hjkim602hjk-lgtm/ROS2_CWU/docs/superpowers/specs/2026-10-30-mission2-design.md

---
title: 미션2 설계 — 빠른 확보 · (3,3)~(7,7) 순환 · 보유 상대 모서리 밀기
tags:
  - cwu/design
  - cwu/nav
---

# 미션2 설계 — 빠른 확보 · 순환 유지 · 보유 상대 밀어내기

**작성일:** 2026-10-30 (사용자와 대화로 확정, Claude 작성)
**대체:** [[docs/superpowers/specs/2026-09-16-mission2-control-design|9-16 codex 초안]]은 회피 위주였고 이 문서가 대신합니다.
**순서:** Gazebo 시뮬레이션에서 먼저 완성 → 그 다음 실물 시험.

## 1. 의도

승리 조건은 "5분 끝났을 때 목표물을 쥐고 있는 로봇"(규정 24조)입니다. 사용자 판단:

1. **빨리 인식하고 빨리 잡는 것이 승패를 가른다.** 출발 직후 중앙으로 곧장 달려간다.
2. 쥔 뒤에는 (5,5) 주위 **(3,3)~(7,7) 테두리 칸(반지름 약 800 mm)을 계속 돈다.** 가만히 서 있지 않는다.
   밀려나면 빠져나와 다시 그 고리로 돌아온다.
3. 상대가 먼저 쥐었으면 **빼앗지 않고, 그 상대를 모서리 탈락 칸으로 밀어 넣는다.** 탈락하면 목표물이
   중앙으로 재배치되므로(23조) 다시 잡으러 간다.
4. 확보 판정: 집게가 닫힘이고 정면 PSD가 임계 이상이면 쥐고 있음. 제대로 잡았다면 움직이고 돌아도 유지된다.

## 2. 목표 / 비목표 / 실패

- **목표:** 시뮬레이션에서 네 대가 같은 거리에서 출발할 때, 5분 종료 시점 보유율을 최대화.
- **비목표:** 상대 그리퍼에서 직접 빼앗기, 상대 정체 식별(팀 구분), SLAM, Nav2.
- **실패로 보는 것(돌아가도):** 우리 로봇이 모서리 칸에 들어감. 상대 몸체를 목표물로 보고 집게를 닫음.
  밀기 중 과격한 반복 들이받기(규정 21조 파손 금지). 경기장 공개 후 값 수정이 필요한 구조(규칙 5).

## 3. 제약

- CLAUDE.md 필수 제약 1~10 그대로. 전부 Pi 4에서, 시작 명령 뒤에는 외부 통신 없음.
- 하드웨어는 미션1과 동일(7번). 펌웨어 속도 모드: `/cmd_vel` → `encoder_odom` → 보드, 집게·무장은 `/base/command`
  ("ARM", "7" 열기, "8" 잡기), 텔레메트리 `/base/telemetry`(PSD raw ADC, 필드 번호는 `mission_logic.py`).
  펌웨어 한계 0.15 m/s, 1.2 rad/s(`fake_board.py`).
- 카메라는 색만 씀. 출력은 `/target/bearing`(방향만, 거리 없음). 거리는 정면 PSD만(CLAUDE.md 카메라 역할).
- 정면 PSD만 파지를 트리거. 튜닝값은 전부 `mission2.yaml`에 넣고 경기장 공개 전에 확정.

## 4. 정해진 설계

### 4.1 경기장 좌표계 (LiDAR 벽)

- 경기장은 내부 장애물이 없는 3600 × 3600 mm 정사각형. LiDAR(높이 170 mm)는 외벽과 로봇만 봄.
  목표물(50 mm)은 LiDAR 아래라 안 보임.
- 좌표계: 원점 = 경기장 중앙, 축 = 벽 방향. 칸 (i,j) 중심 = ((i-5)·0.4, (j-5)·0.4) m.
- 네 출발 칸 (2,2)/(2,8)/(8,2)/(8,8)은 중앙 기준 90° 대칭이고, 이 미션에서 의미 있는 곳(중앙, 고리, 네 모서리)도
  모두 대칭이라 **어느 출발 칸인지 알 필요가 없음**. 출발 시 로봇이 있는 사분면을 (2,2)로 정의함. 시작 위치 인자 없음.
- 추정: 엔코더 odom을 예측으로 쓰고, 스캔에서 벽 직선을 찾아 보정함. 벽만 인정하고 상대 로봇은 버림
  (예: 경기장 크기에 맞는 긴 직선만 쓰고, 예측 벽 위치에서 먼 짧은 점 묶음은 무시). 구체 알고리즘은 빌더 몫이지만
  **두 개 이상의 벽이 가려지는 경우에도 위치가 튀지 않아야 함**. 기존 `grid.py`의 `lattice_fix`·`wall_heading`을 먼저 검토할 것.
- **보정 때문에 멈추지 않음(Claude 결정):** 미션1은 늦게 오는 스캔 때문에 멈춘 뒤에만 보정했지만, 미션2는 계속 움직여야
  하므로 스캔 시각(stamp)의 odom 자세(TF 이력)에 스캔을 붙여 주행 중에도 보정. Pi에서 스캔마다 돌 수 있게 계산량을 잴 것
  (`lattice_fix`는 한 번에 약 54 ms).

### 4.2 상태와 동작

| 상태 | 들어오는 조건 | 하는 일 |
|---|---|---|
| `SPIN` | 출발 | **바로 제자리 반시계(왼쪽) 회전**(사용자 결정). 목표물 위치가 정해져 있고 출발 자세에서 중앙이 왼쪽에 있으므로 돌면서 카메라로 빨간색을 찾음 → 보이면 즉시 `APPROACH`. 정해진 각도(YAML, 중앙 방향 + 여유)를 다 돌아도 안 보이면 `RUSH` |
| `RUSH` | `SPIN`에서 못 찾음, 놓침, 상대 탈락 | 중앙 방향으로 최고속 직진. 카메라에 빨간색이 잡히면 `APPROACH` |
| `APPROACH` | 바닥의 목표물이 보임 | 미션1처럼 빨간색을 화면 세로 중앙선에 맞추며 전진, 정면 PSD 임계 지속 → 정지 → "8" 닫기 → `HOLD` |
| `HOLD` | 확보 판정 참 | 고리 순환(4.3). 놓침 판정 → "7" 열기 → `RUSH`(목표물 재탐색) |
| `PUSH` | 상대가 쥐었다고 판정(4.4) | 보유 상대를 가장 가까운 모서리 칸으로 밀기(4.5). 대상 소실/탈락 → `RUSH` |
| `FINISH` | 경기 시간 300 s 경과(온보드 단조 시계) | 정지, 집게는 닫힌 채 유지 |

- **목표물이 안 보일 때(`RUSH`):** 중앙을 바라보며 중앙으로 감. 중앙 근처까지 와도 안 보이면 제자리에서 돌며 찾음.
  23조에 따라 재배치는 "중앙 주변"일 수 있으므로 정확히 (5,5)라고 가정하지 않음.
- **모서리 금지(모든 상태 최우선):** 네 모서리 칸(1,1)(1,9)(9,1)(9,9) + 로봇 반지름 + 여유(YAML)는 진입 금지.
  금지 영역 쪽으로 향하는 속도 성분은 잘라냄. 위치 신뢰도가 낮으면 모서리 쪽 이동 정지.
- **파지 활성화는 `APPROACH`에서만.** `PUSH` 중에는 정면 PSD가 상대 몸체에 반응해도 닫지 않음.

### 4.3 순환 (HOLD)

- 경로: (3,3)~(7,7) 테두리 칸 중심을 지나는 고리. 반지름 약 800 mm(정사각형 테두리 또는 원 — 빌더 몫, 단 칸 (3,3)~(7,7)
  테두리 안에 머물러야 함). 방향은 한쪽으로 고정.
- 쥔 위치에서 고리의 가장 가까운 점으로 합류. 밀려서 고리를 벗어나면 다시 가장 가까운 점으로 합류.
- **상대가 다가오면 피함(사용자 결정).** 상대 반대쪽으로 비킨 뒤 고리로 다시 합류. 비키는 방향에도 모서리 금지(4.2)가
  우선하므로 모서리 쪽으로는 비키지 않음. 다가옴 판정 거리·비키는 거리는 YAML.
- 순환 중에도 확보 판정을 계속 확인.

### 4.4 확보·놓침·상대 보유 판정

- **우리 확보:** 집게 닫힘 완료 AND 정면 PSD ≥ 임계(기존 `psd_threshold` 550)가 연속 N 표본.
- **놓침:** 집게 닫힘인데 정면 PSD < 임계가 보정된 시간 이상 지속. 순간 튀는 값으로 놓지 않음.
- **상대 보유:** 빨간색 방향선 위에 LiDAR 물체(=로봇)가 있고, 그 물체가 중앙에서 일정 거리(YAML) 이상 떨어져 있음.
  목표물은 LiDAR에 안 보이므로 "빨간 방향에 LiDAR 물체가 걸린다 = 누가 들고 있다"로 봄. 바닥에 놓인 목표물을
  상대가 그냥 가리고 있는 경우와의 구분은 시뮬레이션에서 다듬음.
- **동시 확보 금지(사용자 결정):** 상대 그리퍼의 목표물을 같이 쥐지 않음(25조 재경기 회피). `APPROACH`에서 파지 직전
  정면에 LiDAR 물체(로봇)가 붙어 있으면 닫지 않고 `PUSH`로 전환. 상대가 중앙 가까이 있어 위 "중앙에서 일정 거리" 조건이
  안 맞아도 마찬가지.
- **LiDAR에 상대가 안 보이면(Claude 결정):** 대비책 없음. 상대가 안 보이면 `PUSH`를 하지 않고 `RUSH`/`HOLD`만 함.
  좌·우·뒤 PSD는 용도 미정이라 쓰지 않음.

### 4.5 밀기 (PUSH)

- 대상 상대 위치(LiDAR 물체)에서 가장 가까운 모서리 칸을 고름.
- 상대의 "모서리 반대편" 지점으로 돌아 들어간 뒤, 상대 → 모서리 방향으로 직진해 밀기.
- 우리 로봇은 모서리 금지 경계 앞에서 멈춤(4.2 금지 규칙이 이것을 강제). 상대만 들어가면 됨.
- 한 번 밀다가 실패(상대가 빠져나감)하면 다시 반대편으로 돌아 들어감. 들이받기 속도는 YAML 상한.

## 5. 시뮬레이션

기존 `cwu_sim`(Gazebo Classic, `fake_board`, `track_recorder`, 웹캠·PSD·LiDAR 모델)을 재사용함.

- **경기장:** 장애물 없는 3.6 m 외벽, 빨간 50 mm 큐브 (5,5). 우리 로봇은 네 출발 칸 중 하나에서 출발(시드로 선택,
  출발 방향은 "중앙이 로봇 왼쪽"(미션1 시뮬레이션과 같은 관례) ± 시드별 작은 오차).
- **상대 3대:** 나머지 출발 칸에서 출발하는 단순 로봇(LiDAR 높이에 걸리는 크기). 스크립트가 움직임:
  중앙으로 돌진 → 먼저 닿은 로봇이 쥠 → 쥔 상대는 돌아다니고, 안 쥔 상대는 보유자를 쫓아감. 속도는 시드로 섞어
  "우리가 먼저 잡는 판"과 "상대가 먼저 잡는 판"이 둘 다 나오게 함.
- **심판 스크립트:** 쥔 로봇을 따라 큐브를 옮김(우리 포함 — 지금 `fake_board`는 쥐면 큐브를 지우는데, 미션2에서는
  지우지 않고 따라붙게 바꿔야 23조 재배치가 가능), 로봇 중심이 모서리 칸에 들어가면 탈락 처리, 보유자가 탈락하면
  큐브를 (5,5)(로봇이 있으면 근처)로 재배치, 300 s에 결과 판정.
- **실행:** `tools/sim/run_maze.sh`와 같은 형태의 한 판 스크립트, 결과 한 줄(시드, 300 s 시점 보유자, 우리 탈락 여부,
  우리 누적/마지막 연속 보유 시간, 처음 잡은 시각).
- **반복 기준:** 여러 시드를 돌려 실패 판을 고침. 우리 로봇의 모서리 진입은 0회여야 함.

## 6. 빌더에게 맡김

- 노드·모듈 구성. 단, 미션1처럼 ROS 없는 판단 함수(좌표계 보정, 고리 목표점, 모서리 금지, 밀기 지점, 판정)를
  pytest로 검증 가능하게 분리.
- 벽 정합 알고리즘, 상대 물체 묶음 방식, 고리 모양(원/사각), 상대 로봇 Gazebo 구동 방식.
- 모든 수치(속도, 여유, N 표본, 시간)는 `mission2.yaml`. 실물 값이 미션1 것과 같은 항목은 미션1 값을 시작점으로.

## 7. 실물로 넘어갈 때 확인할 것

- 상대 로봇이 벽을 가릴 때 위치 추정이 버티는지, 밀릴 때 엔코더가 미끄러져도 벽 보정으로 돌아오는지.
- 쥔 상태로 돌고 밀릴 때 정면 PSD가 임계 이상으로 유지되는지(사용자 주장 확인).
- 실제 상대 로봇 크기·높이가 LiDAR에 걸리는지.

## 관련 문서

- [[docs/competition_rules|대회 규정]] 15~27조
- [[docs/superpowers/specs/2026-09-16-mission1-control-design|미션1 제어 설계]]
- [[docs/superpowers/specs/2026-09-16-psd-gripper-design|PSD 자동 파지 설계]]
