hjkim602hjk-lgtm/ROS2_CWU/docs/2026-09-29-실물-주행-시험-기록.md

---
title: 2026-09-29 실물 주행 시험 기록
tags:
  - cwu/hardware
  - cwu/log
---

# 2026-09-29 실물 주행 시험 기록

Nucleo-F446RE 모터·엔코더와 `encoder_odom`을 실물 로봇으로 처음 맞춰 본 날의 기록입니다.
결론부터: **엔코더 오도메트리는 직진에서 맞지만, 모터 출발 순간의 전기 잡음으로 Nucleo의 USB 시리얼(ST-Link)이 깨지거나 멈춥니다.** 제자리 회전 오도메트리는 아직 검증되지 않았습니다.

## 구성

- 전원: 배터리에서 선을 따로 빼 USB-C로 Pi에 공급. 모터 전원은 같은 배터리에서 MDD10A로 들어가며, 로봇에서 따로 끌 수 없음.
- Pi ↔ Nucleo: USB(`/dev/ttyACM0`, ST-Link V2.1 `0483:374b`), 115200 baud.
- 펌웨어: 팀 원본(커밋 `44f761e`, `changwon_robot_2026-09-29.zip`)에 안전 수정을 더한 판. 현재 파일은
  `firmware/nucleo/legacy/changwon_robot_stm_20260929.ino.txt`. 한 글자 명령 `f b l r s z 1 2`, 출력 `ENC,<left>,<right>` 100 ms마다, 고정 PWM 100.

## 실측 값 (`src/cwu_base/config/encoder.yaml`에 반영)

| 항목 | 값 | 근거 |
|---|---|---|
| 바퀴 반지름 | 0.04265 m | 지름 85.30 mm 실측 |
| 트레드 | 0.20686 m | 206.86 mm 실측 |
| 회전당 틱 | 3009.5 | 손으로 1회전: L 3004, R 3015의 평균 |
| 필드 / 부호 | L=0, R=1, 부호 +1 | 전진 시 둘 다 증가 확인 |
| PWM 100 바퀴 속도 | 약 0.14 m/s (100 ms당 약 155틱) | 바퀴 띄운 시험 |

## 시험 결과

| 시험 | 결과 |
|---|---|
| 직진 1 m | `/odom` 1.039 m 전진, 오른쪽 12.5 cm / 실측 약 1 m, 약 12 cm. **옆 방향 일치.** 앞 방향 약 4 cm 차이는 정밀 재측정 필요(맞으면 반지름 약 0.04105 m로 보정). 오른쪽으로 휘는 것은 좌우 모터 속도 차이 → 속도 제어로 해결할 문제. |
| 제자리 회전(1차, 명령 만료 전 펌웨어) | 실제 반시계 약 1050°, `/odom`은 −15.5°. 회전 중 엔코더 데이터가 세 번 끊김. **실패, 원인 미확정.** |
| 재시도 | ST-Link 시리얼이 완전히 멈춤. USB를 뽑았다 꽂아야 복구. |
| 명령 만료 정지 | `f` 한 번 → 0.299초 뒤 `CMD: TIMEOUT STOP`. **동작.** |
| 바퀴 띄운 f/l/b/r 각 2초 | 달리는 동안은 줄 누락·역행 틱 없음. **출발 순간에만** 바이트가 깨짐(`CMD: RIGH552`, `ENC,CMD: LE7`)·0.5초 끊김 1회. 끊긴 동안 Pi → Nucleo 명령도 막혀 명령 만료 정지가 한 번 작동. |
| 바닥 한 바퀴(목표 틱 7298) | 출발 직후 Nucleo → Pi 수신만 멈춤. 명령은 계속 전달돼 로봇이 약 570° 돌고 스크립트의 8초 제한에서 정지. USB 재연결로 복구. |
| 바퀴 띄운 f/l/b/r 각 2초 (소프트 스타트판) | 네 방향 모두 공백·깨진 줄·역행 틱 없음. 출발 틱 54 → 123 → 147로 소프트 스타트 확인. **출발 잡음 해결.** |
| 바닥 한 바퀴 (소프트 스타트판) | 7336틱에서 스스로 정지, 계산 약 364°, 실제도 제자리 복귀(눈으로 확인). 시리얼 멈춤 없음, 주행 중 0.2 s 공백 1회. **통과.** |
| 바닥 직진 1 m (소프트 스타트판, 카메라 연결) | 주행 중 0.2 s 공백 3회·깨진 줄 후 2.87 s(약 0.3 m)에 안전 정지, 이후 ST-Link 수신 멈춤. 커널 로그: 14:45부터 11분간 USB over-current 5609줄, RealSense 재연결 153회, 저전압 기록(`throttled=0x50000`). 재꽂은 뒤 `/dev/ttyACM0`가 root 0600으로 생겨 재부팅. |
| 바닥 직진 0.8 m (재부팅, **카메라 뺌**) | `throttled=0x0`, over-current 0, USB 재연결 없음, 시리얼도 멈추지 않음. 그래도 주행 중 0.2~0.39 s 공백 7회·깨진 줄(`ENC,352`, 오른쪽 증분 4106 등)로 4.78 s에 안전 정지. 엔코더 최종값 L 6202 / R 6072틱(정지 후 관성 포함) → **약 0.55 m**. 스크립트의 누적 4796틱(0.43 m)은 한 줄에 400틱 넘게 뛴 구간을 빼고 세서 적게 나온 값. 줄자 실측은 안 함. **USB 전원 문제와 별개로 주행 중 데이터 깨짐이 남음 → 배선 보강(A) 필요.** |
| 바닥 직진 1 m (2026-09-30, 카메라 뺌, 끊김 기준 1 s) | 목표 11231틱. 주행 중 0.2~0.29 s 공백 4회는 무시하고 진행. 8.02 s에 ST-Link가 **양방향** 약 5초 멈춤 → 스크립트 write가 막혀 루프 정지, 펌웨어 명령 만료로 모터 정지. 복구 후 엔코더 L 11309 / R 11308틱 → **약 1.007 m**. **실측 0.98 m, 옆 틀어짐 육안으로 안 보임** → 엔코더가 2.75% 길게 셈. 유효 반지름 0.04265 → **0.04151 m**로 보정(`encoder.yaml`, `motor.yaml`). 이후 스크립트에 `write_timeout` 추가. |
| 바닥 한 바퀴 재시험 ×2 (2026-09-30, 새 반지름, 목표 7499틱) | 두 번 모두 **출발 0.1~0.2초 만에 Nucleo → Pi 수신이 멈춤**. 1 s 끊김 기준으로 정지. 1차 뒤 엔코더가 L −1376 / R +1324 늘어 있어, 수신이 끊긴 채 약 1초(약 60°) 더 돈 것으로 봄(송신은 살아 있던 한 방향 멈춤). 2차 뒤에는 포트 열기·읽기까지 막힘 → USB 재연결 필요. `throttled=0x0`, USB 커널 이벤트 없음. 어제 같은 시험은 통과했으나 오늘은 2/2 실패. |

## 끊김 현상 정리 (2026-09-30 기준)

Nucleo ↔ Pi 시리얼(ST-Link USB)에서 본 끊김은 여섯 가지입니다. 원인은 크게 **모터 잡음**(1~5)과 **Pi 전원 부족**(6) 두 갈래입니다.

| # | 현상 | 언제 | 원인(판단) | 대응 / 해결 방법 | 상태 |
|---|---|---|---|---|---|
| 1 | 출발 순간 바이트 깨짐·0.5 s 끊김 | 09-29, 바퀴 띄움 | 모터가 0 → PWM 100으로 한 번에 켜질 때 돌입 전류 잡음 | 펌웨어 소프트 스타트(10 ms마다 PWM +4) | **해결** — 바퀴 띄운 4방향 모두 깨끗 |
| 2 | 주행 중 0.2~0.4 s 끊김·깨진 줄 | 09-29~30, 바닥 | 바닥 부하 전류가 큰 상태의 모터선 잡음 | 엔코더가 누적값이라 다음 정상 줄에서 거리 복구, `encoder_odom`은 튄 값 버림, 모터 속도도 유지됨 → **무시하기로 함**(사용자 판단). 시험 스크립트 끊김 기준 0.3 → 1 s | 영향 없음, 남아 있음 |
| 3 | **한 방향 완전 멈춤**: Nucleo → Pi만 죽고 명령은 계속 감 | 09-29 바닥 회전(약 570°), 09-30 회전 1차(약 60° 더 돎) | 2와 같은 잡음이 더 심할 때 ST-Link 송신 쪽이 멈춤 | 펌웨어 명령 만료(300 ms)로는 못 막음 → **Pi 쪽에서 엔코더가 끊기면 명령 중단**(스크립트 1 s, 앞으로 모터 노드 필수 요건). 복구는 USB 재연결 | 안전 정지로 막는 중, 원인 남음 |
| 4 | **양방향 멈춤** 약 5초 후 저절로 복구 | 09-30 1 m 직진 8 s | 같은 잡음 | 명령도 안 가서 펌웨어 명령 만료가 모터를 세움(안전). 다만 Pi의 write가 막혀 프로그램 전체가 멈춤 → `write_timeout` 추가 | 안전, 원인 남음 |
| 5 | 포트 열기·읽기까지 막힘 | 09-30 회전 2차 후 | ST-Link가 완전히 멈춘 상태 | USB 재연결 | 원인 남음 |
| 6 | USB 과전류 폭주·Pi 저전압 → 모든 USB 장치 재연결 | 09-29 14:45~14:56, 카메라 연결 | Pi 5 V 공급 부족 + RealSense 전류(Pi 4 USB 합계 1.2 A). 모터 부하로 배터리 전압이 처지면 악화 | 카메라 빼니 사라짐(시험용 우회). 재연결 뒤 포트가 root 0600이면 Pi 재부팅. **근본: Pi 5 V 변환기 5.1 V 3 A 이상으로 확인·보강** | 우회만 함, **대회 전 필수** |

포트를 열 때 맨 앞 줄이 잘리거나 쌓인 줄이 몰려 들어오는 것은 잡음이 아니라 버퍼 문제라 무시합니다.

### 1~5의 근본 해결 후보

- **A. 배선 보강**: Nucleo GND ↔ MDD10A GND 굵은 선 직결, 모터선 쌍마다 꼬기, 신호선과 분리. 부품 없이 가능, 효과는 시험해 봐야 앎.
- **B. ST-Link 우회 (추천)**: F446 하드웨어 UART ↔ Pi GPIO UART 직결(TX·RX·GND, 3.3 V). 3~5는 모두 ST-Link USB가 멈추는 현상이고, 09-30 회전은 2/2로 출발 직후 멈춰 시험 자체가 안 됨. 대회 중 멈추면 USB를 다시 꽂을 수 없으므로 가장 약한 고리를 빼는 쪽이 확실함. 펌웨어 시리얼 포트 변경과 Pi UART 설정 필요.
- 세라믹 콘덴서(모터 단자)는 현재 없습니다.

**결정 (2026-09-30): B로 갑니다.** 배선은 Nucleo A0(PA0, UART4 TX) → Pi GPIO15/RXD(10번), Nucleo A1(PA1, UART4 RX) ← Pi GPIO14/TXD(8번), GND ↔ GND(6번).
USART1(D8)·USART6(PC7=D9)은 모터 핀과 겹쳐 제외했습니다. A2~A5는 PSD용으로 남습니다.
펌웨어 빌드 설정(`SERIAL_UART_INSTANCE=4`)과 ROS 기본 포트(`/dev/ttyAMA0`)는 바꿨습니다. 새 펌웨어 업로드·Pi UART 설정(`disable-bt`, 콘솔 제거)·실물 확인은 아직 안 했습니다. 세부는 README의 "Nucleo ↔ Pi 통신" 절.

## 오늘 바꾼 것

| 파일 | 내용 |
|---|---|
| `firmware/nucleo/legacy/changwon_robot_stm_20260929.ino.txt` | ① 명령 만료 정지: 마지막 이동 명령 후 300 ms면 정지, Pi는 100 ms마다 재전송. ② 소프트 스타트: 목표 PWM까지 10 ms마다 4씩 올림(0 → 100 약 0.25초). 정지·만료는 즉시 0. **소프트 스타트판은 Nucleo에 올렸으나(사용자 확인), 올린 직후 Pi가 네트워크에서 응답하지 않아 동작 확인은 못 함.** |
| `src/cwu_base/cwu_base/encoder_odom.py` | 바퀴 속도 상한(`max_wheel_speed` 0.5 m/s)을 넘는 틱 증분은 깨진 줄로 보고 버림. 기준점을 유지하므로 다음 정상 줄이 이동을 모두 되찾음. 숫자 가운데 바이트가 빠진 줄 때문에 `/odom`·TF가 한 표본 동안 약 10 cm 튀던 문제. |
| `src/cwu_base/test/test_protocol.py` | 위 동작의 회귀 테스트. cwu_base 19개 통과, `colcon build` 통과. |
| `src/cwu_base/config/encoder.yaml` | 위 실측 값과 `max_wheel_speed`. |

legacy 펌웨어는 `src/`가 아니므로 이렇게 빌드합니다: 임시 폴더에 `platformio.ini`를 복사하고 `.ino.txt`를 `src/main.ino`로 복사한 뒤 `pio run -d <폴더>`. 업로드는 빌드된 `firmware.bin`을 Pi로 보내고, Pi에서 `sudo mount /dev/sda /mnt && sudo cp ~/firmware.bin /mnt/`(Nucleo 드라이브 `NOD_F446RE`).

## 같은 날 codex가 올린 초안 (검토 전)

`firmware/nucleo/src/`가 속도 PI 제어 펌웨어(`CFG`/`ACK`/`VEL`, 가속 제한 포함)로 바뀌었고 `motor_bridge.py`, `motor_safety.py`, `motor.yaml`이 추가됐습니다. 튜닝 값이 모두 `-1`이라 아직 로봇을 움직일 수 없습니다. 새 펌웨어는 `ENC,<ms>,<L>,<R>,<session>`을 보내므로 **올리기 전에 `encoder.yaml`의 `left_field`/`right_field`를 1/2로 바꿔야 합니다.**

## UART 전환 진행 상태 (2026-09-30 밤 기준)

ST-Link USB 끊김(위 3~5) 때문에 Nucleo UART4 ↔ Pi GPIO UART 직결로 바꾸는 중입니다.

| 단계 | 상태 |
|---|---|
| 핀 선정: Nucleo A0(PA0, UART4 TX) → Pi GPIO15/RXD 10번, A1(PA1, RX) ← GPIO14/TXD 8번, GND ↔ 6번 | **완료.** STM32duino 보드 정의로 확인. D3~D10(모터·엔코더)과 안 겹침, A2~A5는 PSD용으로 남음 |
| 펌웨어 | **완료(레포).** `firmware/nucleo/platformio.ini`에 `SERIAL_UART_INSTANCE=4`, `PIN_SERIAL_RX=PA1`, `PIN_SERIAL_TX=PA0`. 코드 수정 없이 `Serial`이 UART4가 됨. legacy·codex 펌웨어 둘 다 빌드 성공, map에 `Serial4` 확인 |
| ROS 기본 포트 | **완료.** `/dev/ttyACM0` → `/dev/ttyAMA0` (encoder/motor yaml, 두 노드, 런치 3곳, `tools/raw_enc_log.py`, README). colcon build 통과, pytest cwu_base 23 · cwu_nav 10 · cwu_slam 12 통과 |
| Pi UART 설정 | **이미 되어 있었음(바꾼 것 없음).** `config.txt`에 `enable_uart=1`·`dtoverlay=disable-bt`, `cmdline.txt`에 시리얼 콘솔 없음, `serial0 → ttyAMA0`(PL011), `ubuntu`는 `dialout`. `hciuart`는 enabled지만 BT 핀 조건 불충족으로 부팅 시 건너뜀, `ttyAMA0` 점유 프로세스 없음 |
| 새 펌웨어를 Pi에 복사 | **완료.** `~/firmware_uart4_legacy.bin` (sha256 `86161535…b9a88f`, legacy 펌웨어 + UART4) |
| 배선 | **안 함** (사용자) |
| 업로드 | **안 함.** 2026-09-30 시점 Nucleo가 Pi USB에 안 꽂혀 있었음(`ttyACM0` 없음), `ttyAMA0` 2초 읽기 0바이트 |
| 통신 확인 | **안 함** |

**다음 순서**
1. 바퀴 띄우기 → 배선(A0→10번, A1←8번, GND↔6번).
2. Nucleo USB를 Pi에 꽂고 사용자 터미널에서 업로드:
   `ssh -t rpi 'sudo mount /dev/sda /mnt && sudo cp ~/firmware_uart4_legacy.bin /mnt/ && sync; sudo umount /mnt'`
   업로드 후에는 ST-Link USB(`ttyACM0`)로 데이터가 안 나옵니다.
3. `/dev/ttyAMA0` 읽기만으로 `ENC` 10 Hz 확인 → 바퀴 띄운 f/l/b/r → 바닥 한 바퀴 재시험(09-30에 2/2 실패한 시험).
4. 이후 위 "다음 할 일" 5번(360° 회전으로 `wheel_separation` 보정), 6번(codex 초안 검토) 계속.

**같이 정리된 결정**
- PSD는 4개: 정면 그리퍼 1개(파지를 시작하는 유일한 PSD) + 좌·우·뒤 각 1개(주변 근접 감지, 용도 미정). README·`CLAUDE.md`·PSD 설계·대회 계획·노션 반영.
- 노션 "배선 · 전원 설계"의 옛 핀표(모터 PB4~PB7, 엔코더 PA0/PA1·PA6/PA7)는 실제 펌웨어와 다름. 경고와 실제 핀을 적어 둠. 실제 로봇 배선이 펌웨어(D3~D10)와 같은지 사용자 확인 필요.

## 연결 검사·Nucleo 무응답 (2026-10-02) — 다음에 여기서 시작

업로드 전에 Blink로 Nucleo ↔ Pi 연결을 확인하려다 F446이 응답하지 않는 것을 발견했습니다.

**한 조치**
| 조치 | 결과 |
|---|---|
| 연결 검사용 Blink 펌웨어 작성: `firmware/blink_check/` (`pio run -d firmware/blink_check`) | 빌드 성공. LD2 1 Hz 깜빡임, `BLINK,n`을 UART4(`ttyAMA0`)와 ST-Link VCP(`ttyACM0`) 둘 다로 출력, 받은 바이트 echo(`ECHO_UART4,x`/`ECHO_VCP,x`), 모터 핀 D6~D9 LOW 고정. Pi `~/firmware_blink.bin` (sha256 `e095dbc1…4c7b64`) |
| sudo 없는 업로드 경로 확인 | ST-Link USB 노드·`/dev/sda`가 `rw-rw-rw-`라 가능. ① `st-flash --reset write ~/firmware_blink.bin 0x08000000` ② `apt download mtools` → `dpkg -x`로 받은 `/tmp/mt/usr/bin/mcopy -i /dev/sda` (마운트 불필요, `/tmp`라 재부팅 시 다시 받기) |
| `st-flash` 업로드(일반, `--connect-under-reset`, `--freq=100k`) | 모두 `Can not connect to target`, `NRST is not connected` 경고 |
| `st-info --probe` | ST-Link V2J39S27는 잡힘, 대상 `chipid 0x0000` — F446 무응답 |
| Nucleo 드라이브 확인 | `FAIL.TXT`: "The interface firmware FAILED to reset/halt the target MCU" (USB 재연결 후에도 다시 생김) |
| 포트 읽기 2 s | `ttyACM0`·`ttyAMA0` 둘 다 0바이트 — 기존 legacy 펌웨어도 안 돌고 있음 |
| 보드 상태(사용자 확인) | LD3(전원) 켜짐, CN2 점퍼 2개·JP6 꽂힘, LD1 초록 고정, LD2 꺼짐 |
| USB 재연결 → 2분 감시 | 재인식 정상, 계속 `chipid 0x0000` |
| A0/A1 선 제거 후 재시도 | 같음 (RESET 핀 오배선 아님) |
| RESET(B2) 누르며 감시 | 첫 감시는 스크립트 인자 오류로 무효, 고친 감시는 `no target`. 그동안 버튼을 눌렀는지는 확인 못 함 |

**판단:** Pi·USB·ST-Link는 정상이고 F446 칩이 SWD에 응답하지 않습니다. 멀티미터 측정은 못 해서 3V3/NRST 전압은 미확인입니다. 칩 손상이 가장 유력합니다(09-29 모터 잡음·Pi 저전압과의 관련은 추정). 여분 Nucleo로 교체하기로 했습니다.

**발생한 문제:** 보드 교체 도중 Pi가 핑·SSH 모두 응답하지 않게 됨. 원인 미확인 — 새 Nucleo를 꽂을 때 저전압으로 재부팅됐을 가능성. 교체 감시 스크립트는 SSH 끊김(종료 코드 255)으로 출력 없이 끝남 — 끊기기 전까지 새 보드는 감지되지 않았고, Blink도 올라가지 않음.

**다음 순서**
1. Pi 전원·부팅 확인 → SSH 복구. `ttyACM0`가 root 0600이면 재부팅.
2. 새 Nucleo: D3~D10 선을 옮기고 A0/A1은 아직 빼 둔 채 USB를 Pi에 연결, 바퀴 띄움.
3. Pi에서 `st-info --probe`로 chipid 확인 → `st-flash --reset write ~/firmware_blink.bin 0x08000000`.
4. LD2 깜빡임 + `ttyACM0`의 `BLINK` 확인 → A0/A1 배선 → `ttyAMA0`에서 `BLINK`·echo 확인.
5. 통과하면 `~/firmware_uart4_legacy.bin`을 올리고 위 "UART 전환 진행 상태" 3번부터 계속.
6. 고장 보드는 따로 보관하고 표시. 멀티미터가 생기면 CN6 3V3/RESET 전압 측정.

## 새 펌웨어·집게 상태 (2026-10-09)

- 보드 펌웨어는 레포 `robot_attached_original.ino`("STM32 ROBOT TEST")입니다. UART4 PC10(TX)/PC11(RX) ↔ Pi 10/8번 핀으로 정상 응답하고, `ttyACM0`(ST-Link USB)는 연결되지 않았습니다.
- 명령: `t` 텔레메트리 켜기/끄기(5 Hz CSV `ms,mode,L,R,PWM_L,PWM_R,PSD_FL,PSD_FR,PSD_L,PSD_R,SERVO_L,SERVO_R`), `a` PSD 회피 주행(명령 만료 없음), `q` 정지, `s` 상태 출력(정지 명령 아님), `1~7` 서보.
- **집게 열림 = 왼쪽 서보(D2) 90°, 오른쪽 서보(D3) 150°.** 사용자가 집게가 "양쪽 다 열림"이라고 확인했을 때 `s` 출력값입니다. 이 값은 펌웨어가 마지막으로 지시한 각도이고, 서보 위치를 측정한 값은 아닙니다. 닫힘 각도는 아직 확인하지 않았습니다.
- 같은 시점 엔코더 L 102097 / R −97301. 좌우 부호가 반대인데, 제자리 회전 때문인지 오른쪽 엔코더 부호가 뒤집혀서인지는 확인하지 않았습니다. SLAM용 설정은 Pi `~/encoder_robot_test.yaml`(필드 2·3, `ticks_per_rev` 1504.75 = x1 디코딩 기준 추정치, 실측 안 함).

## V3 펌웨어 SLAM 매핑·자동 보정 (2026-10-11~12)

보드 펌웨어는 `RobotServoCalibrate (1).ino`(ROBOT40_V3)로 통일. 키보드·자동 주행으로 SLAM을 돌리며 아래를 실측으로 고침.

| 문제 | 근거 | 조치 |
|---|---|---|
| 직진이 왼쪽으로 휨 | 개방루프 PWM. 바닥 PWM 40→100에서 좌우 차 ≤11% (`tools/pwm_step.py`) | 펌웨어 `[V좌,우]` 틱/s 바퀴별 PI, 이득은 Pi YAML이 `[G..]`로 1 s마다 전송 |
| 지도가 부채꼴로 번짐 | 제자리 좌회전에 스캔이 같은 방향으로 돎 | `ydlidar_g4.yaml` `inverted: true` |
| 라이다가 거꾸로 장착 | 0.5 m 직진 전후 스캔 전수 정합: 이동방향 라이다 −178.8° | `mount.yaml` yaw = π, 이후 정밀값 176.4° |
| 출발 순간 PSD 오정지 | 모터 잡음으로 PSD 한 샘플이 550 넘음 | PSD 정지 20 ms 연속 조건 |
| 낮은 장애물에서 바퀴 헛돎 | odom 0.2 m 진행, 스캔 0 m (라이다 높이 170 mm 아래, 앞 PSD도 못 봄) | `tools/wander.py`: 스캔 3 s 불변이면 후진·회전 |
| **SLAM이 직진을 ~55%로 깎음** | odom 1.036 m / SLAM 0.453 m. 같은 스캔 직접 정합은 0.49 m | 아래 SLAM 비교 |

**odom 보정** (`tools/odom_calib.py`, 자동주행 녹화 2개, 스캔쌍 151개, 미끄럼 쌍 제외):
바퀴 간격 0.20686 → **0.1974 m** (회전을 4~5% 작게 셈), 반지름 0.04151 → 0.04158, 좌/우 배율 **0.9939 / 1.0061**
(같은 틱이면 오른쪽이 1.2% 더 감 → 왼쪽으로 휘던 원인), 라이다 장착각 **176.4°** (적용 후 이동방향 차 +0.19°).
스캔 시간표 0.1 s 오프셋은 SLAM 결과에 영향 없어 보정 안 함.

**SLAM 비교** (`tools/slam_replay.py` + `tools/slam_eval.py`: 녹화를 PC에서 도메인 77로 재생, 25 cm/25° 구간마다 스캔 정합 이동량과 비교):

| 설정 | 녹화1 (42쌍) | 녹화2 (109쌍) |
|---|---|---|
| 로봇 기존 (5 cm마다 정합) | 4.7 cm / 4.57° | 5.9 cm / 1.45° |
| odom 보정만 | 4.8 / 2.04 | 5.8 / 1.26 |
| + 정합 간격 25 cm | 2.4 / 2.52 | 2.4 / 2.52 |
| **+ 간격 25 cm + odom 신뢰 강화 (채택)** | **1.1 / 1.41** | **1.5 / 1.12** |
| (참고) 정합 끔 = odom만 | — | 1.1 / 0.80, 지도는 누적 회전으로 번짐 |

효과 없음: 지도 해상도, 루프 클로저, barycenter, 탐색 범위, 페널티 바닥값만 조정, 장착 오프셋 처리(스캔 각도 이동 실험).
레포 Cartographer 설정은 7.0 cm / 11.7°로 더 나쁨.
원인: 5 cm마다 순차 정합하면 매번 생기는 작은 "덜 움직임" 편향이 누적.

**실물 확인** (적용 후): 0.8 m 전진 odom 0.828 / SLAM 0.818 m, 후진 0.827 / 0.837 m (이전 1.036 / 0.453).

## 2026-10-29 펌웨어 전환: Nav2 제거, 칸 단위 이산 주행 — 다음에 여기서 시작

팀원이 보드를 새 `RobotIntegrated.ino` + `MotorControl.h`(X4 엔코더, RPM 속도 PI)로 바꿨습니다. 이 판에는 BASE_NAV_V1
속도 모드(`[N1]` `[ARM]` `[V…]` `[PF0/1]`)가 없어 Nav2(RPP)·collision monitor를 쓸 수 없습니다. 사용자 결정: 새 판 기준,
펌웨어는 작은 추가만 요청, SLAM은 slam_toolbox 유지, 주행은 400 mm 칸 BFS + "회전 → 직진".
규약·요청 목록은 `README_STM_PI_INTERFACE.md` 0절.

- **바꾼 것:** `encoder_odom`(t 스트림·`!` 10 Hz·`/base/command` 허용 목록, 무장·cmd_vel 삭제, counts/mm 5.759/5.671,
  윤거 0.2016, 끊김 1 s), `cwu_nav/grid.py`(칸 판정·BFS·다음 명령·직진 통로 검사), `mission1.py` 재작성
  (RELEASE → LOOK 45°씩 → GOTO 칸 이동 → APPROACH 회전/F100 → 정면 PSD 정지 = 파지 → RETURN → DONE),
  `slam.yaml` `transform_timeout` 0.5, `mission1.launch.py`에서 Nav2 제거.
- **지운 것:** Nav2 설정·BT·launch, `drive_config`·`go_home`·`target_follower`·`motor_bridge`·`motor_safety`·`motor.yaml`,
  관련 검사, `tools/` 의 cmd_vel·Nav2·구 프로토콜 도구(`teleop_keys`, `wander`, `loop_obstacle`, `pwm_step`, `tick_measure`,
  `raw_enc_log`, `field/restart_stack·trial·loop_trial`). 커밋 84e5663까지에 있음.
- **검증(하드웨어 없음):** pytest cwu_nav·cwu_base 37개, `run_mission1_check.py` 12/12(가짜 보드: 막힌 칸 우회·TR17·F100·
  PSD 파지·복귀), `run_encoder_check.py` 통과, flake8(cwu_nav·cwu_base) 경고 0. 복귀 경로 없음 → 옆 칸 재시도 분기는
  흐름 검사에 없음(코드 검토만).
- **펌웨어 Pi 추가분 (같은 날, 사용자 요청):** 레포 `RobotIntegrated.ino`에 `[PF0]/[PF1]` 운반 모드, 정면 PSD 60 ms 유지,
  제자리 회전 PSD 정지 없음, 잡기 99/78 — 그 밖의 변수 값은 팀원 판 그대로 (근거는 `README_STM_PI_INTERFACE.md` 0절). PlatformIO 빌드 성공(Flash 10.5%),
  빌드 결과 `build/fw_check/.pio/build/nucleo_f446re/firmware.bin`. **22:47 업로드 완료** (Pi `~/firmware_newbase_pf_2026-10-29.bin`,
  덮어쓰기 전 백업 `~/board_backup_2026-10-29.bin`). UART 확인: `h`에 `8: GRIP 99/78`·`[PF0]/[PF1]`, `[PF0]`→`# FRONT_PSD_OFF`,
  `# CAL,5.759145,5.671041`. 아래 실물 순서 ①(바퀴 띄운 F400·TL90)은 사용자 결정으로 생략.
- **보드 안전장치 제거 (같은 날, 사용자 결정):** 펌웨어에서 하트비트와 직진 중 정면 PSD 정지(`[PF0/1]` 포함)를 빼고 텔레메트리 20 Hz.
  정면 PSD 정지는 `mission1`이 텔레메트리 두 표본(≥ 550) 연속이면 `q` → 그 정지를 파지 판단에 씀. `encoder_odom` 하트비트 제거,
  `timeout` 0.5 s. 흐름 검사 12/12(가짜 보드가 `q`에 `# STOP`). **이 판은 아직 업로드 안 함** — 보드에 있는 22:47 판은 하트비트를 요구하므로
  새 Pi 코드와 같이 쓰면 이동이 `# REJECT HEARTBEAT_REQUIRED`로 거절됨.
- **실물 순서:** ① 바퀴 띄우고 `ros2 topic pub --once /base/command std_msgs/String "{data: F400}"`·`TL90` → `/odom` 0.4 m·90°,
  `encoder_odom` 끄면 0.7 s 안에 `# ABORT HEARTBEAT_TIMEOUT` ② 400 mm 칸에서 TL90 ×4 → SLAM yaw 오차, 회전 중 `PSD_PIVOT` 빈도
  ③ 회전 0.7 rad/s·odom 5 Hz에서 SLAM 정합 — 녹화를 `tools/slam_replay.py`로 재생해 각도 페널티 확인
  ④ 개활지 파지·복귀 3회 ⑤ 모의 경기장 3회.

## 미션 1 실행 경로 (2026-10-14)

계획: `~/.claude/plans/peaceful-petting-crab.md`. 한 명령으로 뜸: `tools/field/start_mission1.sh`
(Pi `setsid nohup ros2 launch cwu_nav mission1.launch.py`, 로그 `~/mission1.log`).

- **흐름** (`cwu_nav/mission1.py`, 판단은 `mission_logic.py`): INIT → 제자리 한 바퀴 → 중앙 힌트 앞(1.18, 1.18)
  → 미탐색 경계 순회. 빨간 목표물 3회/1 s 검출 → Nav2 취소, 화면 중앙선 정렬 후 직진(0.06 m/s)
  → 보드가 정면 PSD 550으로 멈추면(접근 중·방금 중앙에 보였을 때만) 집게 닫기 + `[PF0]` → 출발점(map 원점) 복귀.
  그 밖의 보드 정지(측면·후면 PSD 등)는 막힌 쪽 반대로 직진 7.5 cm 후 재개, 60 s에 8회 넘으면 정지.
- **출발 자세(사용자 확정):** (9,1)에서 x축을 등지고 +y 방향. (1,9)는 점대칭으로 놓아야 같은 힌트가 맞음.
- **펌웨어:** `RobotIntegrated.ino`에 `[PF0]/[PF1]`(운반 중 속도 모드 정면 PSD 정지만 끔) 추가·업로드·응답 확인.
  직전 이미지 Pi `~/board_backup_2026-10-14b.bin`. `README_STM_PI_INTERFACE.md` 9절에 기록 → **STM 담당에게 공유 필요.**
- **encoder_odom:** `/base/telemetry`(CSV 12정수), `/base/event`(`#` 줄), `~/carry`(SetBool: `8[PF0]` / `7[PF1]`),
  `~/arm` 응답 success = 이미 무장됨.
- **motor.yaml:** `safety_margin` 0.05 → 0.015 (collision monitor 원 0.215 → 0.18). 400 mm 칸 중앙에서 벽이 0.20 m라 0.215면 출발 칸에서 못 움직임.
- **카메라:** RealSense로 교체 결정(사용자). 지금 로봇엔 USB 웹캠이 달려 있음 → 교체와 Pi 5 V 전원 확인 필요.
- **검증:** PC 테스트 42개 통과, `run_mission1_check.py`(가짜 보드·Nav2로 INIT→SPIN→GOTO→BACKOFF→APPROACH→GRASP→RETURN→DONE) 통과.
  Pi 빌드·단위 테스트 15개 통과. Pi에서 통합 검사를 돌리던 중 Pi가 꺼짐(21:5x, `last`에 crash). 커널 로그에
  저전압·OOM·panic 없이 21:31 웹캠 메시지가 마지막 → 갑작스런 전원 차단 추정, 원인 미확인. 재부팅 후 같은 검사는 Pi에서도 통과(부하 0.5).
- **400 mm 상자 PSD 실측 (2026-10-14 22:2x):** 로봇을 장애물로 둘러쌈. 라이다로 잰 중심~장애물 / 몸체와의 틈 / PSD raw:
  앞 0.200 m / 35 mm / **313** · 왼 0.195 / 30 / **886** · 뒤 0.197 / 32 / **715** · 오 0.216 / 51 / **616**.
  → 펌웨어 규칙대로면 측면·후면이 550을 넘어 회전·후진 불가(출발 칸·400 mm 통로 통과 불가).
  정면 313은 35 mm 앞 장애물에도 임계 미만(집게가 앞으로 나와 근거리 반전 구간일 수 있음, 미확인).
- **펌웨어 변경(사용자 결정, 업로드·응답 확인):** 속도 모드 PSD 검사 방향을 바퀴별 부호 대신 몸체 전진 속도 (vL+vR)/2로 판단.
  |v| ≤ 10 mm/s(제자리 회전)는 PSD 정지 없음, 전진=정면, 후진=후면, 곡선=좌우까지. 백업 Pi `~/board_backup_2026-10-14c.bin`.
  **상자 안 제자리 회전 시험 (22:3x):** `[V0,0.3]` 반 바퀴 → ABORT 없이 181.5°(엔코더, 윤거 0.1904), L −1864 / R +1723틱.
  회전 중 PSD 최대 왼 907 · 뒤 868 · 오 820 · 앞 376 (예전 규칙이면 즉시 정지). 접촉 여부는 사용자 육안 확인 필요.
- **카메라:** 사용자 결정으로 USB 웹캠 사용. `camera.launch.py driver:=webcam`(기본)이 usb_cam(`webcam.yaml`, 640x480 MJPEG 10 fps)을 띄움.
  `webcam_info.yaml`: 큐브 정면 약 1 m u0=297.5, 오른쪽 약 0.2 m u1=387.3 → **fx≈450**(수평 화각 약 71°), cx=297.5(로봇 정면 열).
  큐브는 v≈162(화면 중앙보다 위)에 찍힘 → 카메라가 위로 들려 있음. 가까이 가면 화면 아래로 빨리 빠질 수 있음(pitch 실측 필요).
  방 안 주황 상자 뚜껑도 빨강 마스크에 걸리지만 모양(가로로 길쭉)으로 걸러짐.
- **웹캠 멈춤 원인: USB 절전.** 쉬었다가 다시 열 때 `snd-usb-audio ... resume error -110` → UVC probe -110 → USB 리셋 반복, 읽던 프로세스 D 상태.
  `/sys/bus/usb/devices/1-1.1/power/control=auto`, delay 2000 ms. 해결: udev 규칙(Pi `~/50-webcam-no-autosuspend.rules`)을 사용자가 설치
  `ssh -t rpi 'sudo cp ~/50-webcam-no-autosuspend.rules /etc/udev/rules.d/ && sudo udevadm control --reload'` 후 웹캠 재연결 → `power/control=on` 확인.
  **적용 완료(22:57):** 규칙 설치·재연결 → `control=on`. `camera.launch.py`(웹캠+검출기) `/target/bearing` = (0.194, −0.167, 0.967)
  → 방향 오차 +11.3°(1 m 앞 오른쪽 0.2 m의 기대값 11.3°), 9.4 Hz. 쉬었다 다시 열어도 정상, -110 재발 없음.
- **집게 시험 (바퀴 띄움, `~/carry` 서비스):** 닫기 → 105/75 도달 2.0 s, `# FRONT_PSD_OFF` · 열기 → 40/140 2.0 s, `# FRONT_PSD_ON`.
  **큐브 없이 닫기만 해도 정면 PSD 579**(열림 9~10) — 닫힌 집게 날이 PSD를 가림. 따라서 `hold_min_raw` 550으로는 놓침 판별 불가.
  **큐브 문 상태:** 열린 날 사이 585(파지 임계 550 넘음 → 파지 위치 판단은 됨), 닫고 문 상태 615(568~699), 다시 열림 574.
  큐브 문 상태와 빈 집게 닫힘(579)이 겹침 → 정면 PSD로 놓침 판별 불가, `hold_min_raw: 0`으로 끔. 운반 중 놓침은 현재 감지 수단 없음.
- **실물 1회차 (23:12, 바퀴 내림, 개활지, 큐브 정면 약 1 m):** `start_mission1.sh` → 16 s 초기화 → SPIN 직후 검출 → APPROACH
  → 40 s 보드 `ABORT PSD_BLOCKED`(정면 591) → 파지 → 42 s 복귀 → **62 s DONE(보유)**. 실제 집·복귀 위치는 육안 확인 필요.
  발견한 것: ① 38~40 s에 APPROACH↔SPIN이 0.05 s마다 반복(확정은 최근 1 s 3회, 상실은 0.5 s 무검출이라 오래된 검출로 재확정)
  → 확정에 0.5 s 안 검출도 요구하도록 수정. ② 배경 실행된 `ros2 launch`가 SIGINT를 무시(비대화형 셸 & 작업) → 노드에 직접 SIGINT 보내는
  `tools/field/stop_mission1.sh` 추가, 시작 스크립트가 먼저 부름. ③ 시작 스크립트의 pkill/pgrep 패턴이 자기 명령줄과 겹치던 것 수정.
- **1회차 실제 결과(사용자 관찰): 큐브를 못 잡음, 복귀는 잘 됨.** 로그 분석: 32 s 첫 정면 PSD 정지가 진짜 파지 기회였으나 최신 텔레메트리 한 줄이
  550 아래(잡음)라 장애물로 오판 → 후퇴 방향도 '없음' → 큐브를 집게 앞에 둔 채 제자리 회전(33~35 s)으로 밀어냄 → 40 s 가짜 파지.
  수정: 파지·후퇴 판단에 최근 0.5 s PSD 최대값 사용, 정지마다 PSD 네 값 로그.
- **2회차 (23:2x): 가짜 성공(20 s, 거의 안 움직임).** 1회차 뒤 집게가 빈 채 닫혀 있었음 → 미션 시작의 집게 열기 도중 접근 명령 → 보드
  `REJECT BUSY`(서보 이동 중) → encoder_odom의 q → 보드 정지가 서보를 96/84에 고정 → 반쯤 닫힌 날이 정면 PSD를 가려 500~700 → 파지 판정.
  빈 채 닫힌 집게의 정면 PSD는 약 500, 잡음으로 570~697까지 튐. 기록: Pi `/tmp/trial2.csv`(텔레메트리·방향·명령·이벤트).
  수정: 미션 시작·재개 전에 집게가 40/140에 도달할 때까지 대기(RELEASE), 파지 판정은 집게가 다 열려 있을 때만.
- **3회차 (23:3x): 실패.** 19~36 s 정렬 오차 평균 −0.3°로 1 m 직진 → 37 s 큐브 앞 보드 정지, 텔레메트리 정면 최대 461~520이라 장애물 판정
  → 후퇴·회전 → 48~84 s 큐브 앞에서 명령 절반이 제자리 회전(좌우 왕복, 사용자 관찰) → 사용자가 큐브 치움. 기록 Pi `/tmp/trial3.csv`.
  집게 열림·앞 빔 정면 ≤185(중앙 67), 큐브 앞 345~520.
- **집게 위치 실측 (정지, 23:4x):** 사용자가 "잡기 좋은 위치"에 큐브 두 번 → 열림 정면 중앙 514(550 이상 20%, 512/580 두 값 오감) · 600(100%),
  닫힘 503 · 594. **둘 다 잘 잡힘(사용자 확인)** → 보드 임계 550은 잡을 위치와 맞음. 미션 판정은 최근 1 s 정면 최대 ≥ 300(`grasp_front_min`)으로
  채택·Pi 반영, 정지 횟수는 ABORT만 1 s 묶음으로 셈. 105/75에서 오른쪽 서보가 혼자 열렸다 닫힘 → **잡기 102/78로 3°씩 완화**(펌웨어 상수·업로드,
  백업 `~/board_backup_2026-10-14d.bin`, `mission1.yaml grip_angles`). 큐브 앞 좌우 왕복 원인(카메라-집게 좌우 어긋남 의심)은 미확인.
  **102/78 재시험:** 열림 정면 중앙 618, 닫힘 595 → 잘 잡히고 오른쪽 서보 떨림 없음(사용자 확인) → 102/78 확정.
- **4회차 (23:5x): 성공(64 s), 사용자 평가 80점** — 잡고 돌아왔으나 등록 위치보다 바깥에서 잡음. 34 s 큐브 앞 정지는 "최근 중앙 아님"으로 후퇴:
  정면 114→307 동안 오차 ±1°였다가 정면 370(y +0.37, 화면 아래 끝)에서 +7.4°로 튀고 끊김 → 큐브가 화면 아래에서 잘려 검출 중심이 흔들림.
  재접근(정면 240~350) 오차 −11.5°↔+10.5° 왕복(3회차 좌우 왕복과 같음, 카메라 좌우 어긋남이 아니라 근거리 검출 불안정).
  41.8 s 파지 때 정면 최대 447 — 보드가 표본 하나의 잡음으로 이른 정지. 기록 Pi `/tmp/trial4.csv`.
- **수정 (2026-10-15 0시, 사용자 승인):** ① 펌웨어 PSD 정지는 조건이 60 ms 계속될 때만(`PSD_HOLD_MS`, 업로드·도움말 확인, 백업 `~/board_backup_2026-10-15a.bin`).
  ② 미션 APPROACH 마지막 구간: 중앙에 보고 들어왔고 정면 ≥ 250(`near_front_min`)이면 카메라 무시하고 직진, 4 s 안에 보드 정지 없으면 SPIN.
  흐름 검사 12/12 ×2, Pi 반영. **실물 시험 전.**
- **5회차 (0시 1x): 성공(사용자 확인), 56 s.** 17 s 검출 → APPROACH → 정면 290에서 PSD 직진 → 34.3 s 보드 정지(정지 직전 정면 …507·544·558·590·641,
  정지 후 열림 604 = 잘 잡히는 위치 600~618) → 파지 → 복귀. 엉뚱한 PSD 정지·좌우 왕복 없음. 기록 Pi `/tmp/trial5.csv`.
- **6회차 (0시 1x): 성공(사용자 확인), 68 s.** 큐브를 비틀어 정면이 아닌 곳(첫 검출 오른쪽 14.4°)에 둠 → 정렬 후 접근 → 정면 355에서 PSD 직진
  → 정지 직전 …532·559·646·608, 정지 후 열림 601(5회차와 같은 깊이) → 파지·복귀. 기록 Pi `/tmp/trial6.csv`.
  집게 왼쪽이 또 말썽 → **잡기 99/78**(왼쪽만 3° 더 완화). 펌웨어 첫 쓰기 `stlink_fwrite_flash() == -1` 실패·보드 무응답 →
  `st-info --probe` 정상(chipid 0x0421) → 재시도 성공·도움말 `8:grip99/78` 확인. 백업 `~/board_backup_2026-10-15b.bin`.
- **모의 경기장 1회차 (0시 3x): 실패.** 한 바퀴 동안 큐브 못 봄 → 힌트·탐색 경계 목표가 약 22 s마다 실패, Nav2 `collision ahead` 반복·정지.
  재부팅 뒤 웹캠 절전이 다시 켜져 있었음(`control=auto`) → udev 규칙에 `autosuspend_delay_ms=-1` 추가(사용자 설치·재연결 후 on/−1 확인).
  Pi 종료(00:26)는 사용자 `sudo shutdown`(auth.log), 스크립트 무관.
- **모의 경기장 2회차 (0시 4x): 성공(사용자 확인), 288 s 보유 복귀.** PC RViz(지도 + Nav2 로컬 비용지도 + 웹캠). 탐색·복귀 중 측면 PSD
  정지 반복(오른쪽 930·832·680·656, 왼쪽 576 — Nav2 곡선 주행은 측면도 검사) → 같은 자리 맴돌며 시간 소모. 기록 Pi `/tmp/arena2.csv`.
- **시험용 펌웨어 (사용자 요청):** `SIDE_REAR_PSD_STOP=false` — 속도 모드 PSD 정지를 정면만. 백업 `~/board_backup_2026-10-15c.bin`. 결과 보고 유지 여부 결정.
- **모의 경기장 3회차 (0시 5x, 측면·후면 PSD 정지 끔): 중단.** 측면 정지는 사라졌으나 화면 왼쪽 끝에서만 −32~−20° 잠깐 보이고 사라지는
  가짜 표적(먼 주황 뚜껑의 잘린 끝이 정사각형으로 통과 추정)으로 15 s마다 발견→접근→상실→한 바퀴 반복. → 검출기가 좌우 가장자리에 닿은
  덩어리를 무시(아래 가장자리는 허용), 테스트 13개.
- **모의 경기장 4회차: 중단.** 가짜 표적 사라짐(검출 1). 출구 옆 장애물 모서리가 몸체 반경 안(로컬 비용지도 빨강이 원 안)에 들어와 RPP가
  모든 경로를 `collision ahead`로 거부, Nav2 회복은 wait뿐이라 같은 자리에서 목표만 22 s마다 바뀜(2회차는 측면 PSD 정지 뒤 7.5 cm 후진으로
  빠져나왔던 것). → Nav2 목표·복귀 실패 시 미션이 7.5 cm 후진 후 다음 목표/재계획(`escape`), 흐름 검사 14/14 ×2.
  RViz/스냅샷의 비용지도는 Transient Local로 구독해야 보임(Nav2가 전체 지도를 한 번만 보냄).
- **모의 경기장 5회차 (1시 0x): 사용자 중지.** 7.5 cm 후진 escape는 동작했으나 진전 없음 → 사용자 요청으로 escape 제거(실패 시 바로 다음 목표).
  힌트(왼쪽 대각선) 목표 32~137 s 동안 Nav2가 계속 움직임(바퀴 기준 약 5.6 m, 왼쪽으로 2바퀴 넘게) — 컨트롤러 `collision ahead` 중단 42회,
  재계획 85회, `Control loop missed 10Hz` 14회. 위치 기록이 없어 실제 궤적은 미확인.
- **Nav2 기준 완화 (사용자 결정):** `motor.yaml robot_radius` 0.165 → 0.150(비용지도 두 개 + collision monitor 원 0.165 = 몸체 바깥선),
  `nav2.yaml inflation_radius` 0.35 → 0.20. Pi 반영. 실물 시험 전.
- **모의 경기장 6회차 (1시 1x, 반경 0.150·여유 0.20): 사용자 중지.** 출구에서 갇히지 않고 x 1.64 m까지 나감. 왼쪽 대각선 힌트(1.18, 1.18)로
  다가가다 돌아서기를 반복(41 s 0.71→46 s 반대 방향, 62 s 1.21→72~82 s 출발점 근처까지 후퇴, 다시 전진) — 경로 계획이 미탐색 공간을 지나는
  길을 냈다가 라이다가 벽을 보면 다른 우회로로 바뀌는 것으로 추정. 168 s 스냅샷: 목표와 로봇 사이에 가로 장애물 띠(SLAM 벽 선과 일치),
  로봇 원 왼쪽 위에 충돌 칸. 큐브 검출 0. 기록 Pi `/tmp/arena6.csv`(위치 5 Hz 포함), 그림 scratchpad `arena6_map.png`.
- **모의 경기장 7회차 (1시 2x, 여유 0.17): 사용자 중지.** 33~163 s 내내 힌트 목표 하나(GOTO) — 미션은 SPIN 안 함. 그 사이 Nav2가 경로를 138번
  재계획하며 x 0~1.1 m를 왕복, 출발점 근처까지 되돌아와 제자리 회전(RPP rotate-to-heading). `collision ahead`는 2번(반경·여유 완화 효과).
  원인 추정: Nav2 BT 회복 동작이 **전역 비용지도를 통째로 지움** — 정적 레이어가 없어 본 벽을 잊고 미탐색 공간을 지나는 막힌 우회로를 반복.
  → `navigate_safe.xml`·`navigate_through_safe.xml`에서 전역 비용지도 지우기 제거(계획 실패 시 1 s 대기 후 재시도), 로컬 지우기는 유지. 실물 시험 전.
- **모의 경기장 8회차 (1시 4x, 트인 방향만 회전 + 전역 비용지도 안 지움): 큐브 파지, 복귀 실패.** 출발 회전 299°(사방 트임) → 힌트 32 s 만에
  실패(전엔 91~105 s), `collision ahead` 0 → 탐색 경계 (1.44, 0.87) 도착 95 s → 시계 172° 회전 중 98 s 큐브 발견 → 185 s 파지(정면 586)
  → RETURN: 출발점 (0, 0) 경로 계획 68번 실패, 25 s마다 재시도. 스냅샷: SLAM 지도(흰색)는 출발점까지 통로가 이어지는데 로컬 비용지도에
  로봇을 둘러싼 장애물 고리(일부는 SLAM 흰색 위) — 라이다 점 누적의 유령 장애물로 추정, 전역 비용지도를 더 이상 지우지 않아 사라지지 않음.
  사용자 지적: "길이 막힌 것도 아닌데 못 간다고 판단", "흰색 공간 중심으로 운전시키면 되잖아". 정지 명령 중 Pi 연결 끊김(ping 무응답) →
  사용자가 배터리 분리. 기록 Pi `/tmp/arena8.csv`(재부팅 시 지워짐), 그림 scratchpad `arena8_map.png`.
- **다음 후보:** ① ~~전역 비용지도 = SLAM 지도~~ (10-16 적용) ② ~~RPP 충돌 검사 끔~~ (10-16 적용)
  ③ 회전 중 오도메트리 vs SLAM 방향 비교 측정(펌웨어 윤거 0.1904는 시계 회전에서 예전 스캔 정합값 0.2040보다
  회전각을 약 4% 크게 셈 → 유령 고리 원인 후보, 미측정).
- **모의 경기장 9회차 (10-15 23:4x, 경기장이 로봇 오른쪽에 있게 놓음): 갇힘.** 29~60 s 힌트 (1.18, 1.18)로 가다 출발점 근처로 돌아와
  왼쪽으로 회전(사용자 관찰) — 힌트는 "경기장이 로봇 왼쪽" 출발 자세를 가정하는데 이번엔 왼쪽 0.35 m가 바깥 벽이라 힌트가 벽 너머.
  106 s부터 (0.27, −0.21)에 서서 탐색 목표 10개 모두 경로 계획 실패. 전역 비용지도 기준 갈 수 있는 면적 0.75 m², SLAM 벽만으로는
  61 m²(모든 목표 도달). 막은 것은 출발점 1.8 m 앞 오른쪽 0~0.5 m의 세로 장애물 칸(SLAM은 빈 칸) — **사용자 확인: 실제로 뚫려 있음** → 유령.
  같은 날 RViz 카메라가 안 보인 이유: PC `python3`가 PlatformIO 가상환경(cv2 없음)이라 `webcam_view.py`가 바로 죽음 → `/usr/bin/python3`.
- **수정 (10-16):** `nav2.yaml` 전역 비용지도 = `static_layer`(`/map`, `footprint_clearing_enabled`로 10-12의 "로봇 위 SLAM 벽 흔적" 방지)
  + inflation, 장애물 레이어·고정 크기 제거(정적 레이어가 /map 크기로 맞춤). Pi에서 SLAM 지도와 칸 단위 일치 확인(198×52, lethal 166 = 166).
  `tools/field/rviz.sh`(RViz + 웹캠 디코더, 닫으면 같이 종료), `slam.rviz`에 전역·로컬 비용지도·경로 표시 추가.
  `run_nav2_check.py` 거부 시험 목표를 상자 한가운데 → 이미 본 상자 서쪽 벽 (0.9, 1.1)로(안 본 면은 미탐색이라 상자 안 경로가 생김).
- **10회차 (10-16 0시 1x): 경로 계획 실패 0, RPP 정지 반복.** 로봇이 오른쪽 벽 0.28 m·왼쪽 앞 물체 0.20 m(둘 다 SLAM에 있음) 사이에서
  4분 넘게 정지, `collision ahead` → `patience exceeded` 20 s마다. 경로–로컬 장애물 최소 0.169 m(> 반경 0.15)인데 RPP는 외곽 원을 5 cm 칸으로
  찍어 사실상 ~0.185 m로 검사. SLAM 벽 vs 실시간 로컬 장애물 어긋남은 중앙값 3.9 cm·최대 8.7 cm. 실행 중 lookahead 0.12~0.35/1.0 s로
  줄여 봤으나 40 s에 116회로 효과 없음 → 되돌림. `use_collision_detection: false`는 Humble RPP가 실행 중 변경을 반영 안 함(재시작 필요).
  → `use_collision_detection: false`(충돌 방지는 collision monitor: 실제 스캔 점 vs 반경 0.165 원, approach + 정면 PSD).
  PC `run_nav2_check.py` 4/4 통과(도달 0.10 m, 복귀 0.10 m, 상자 벽 거부, 경로 연결). 가상 방엔 400 mm 통로가 없어 실물로만 확인 가능.
- **11회차 (10-16 0시 3x, 경기장이 로봇 왼쪽): 성공, 229 s 보유 복귀(로그 기준).** 31 s 반시계 299° → 힌트 → 66 s 시계 170° → 탐색 →
  148~162 s 접근(PSD 직진 3번째에 정면 609로 파지) → 164 s 복귀 시작 → (0.33, 1.31)에서 출발점까지 Nav2 한 번에 성공 → 229 s DONE.
  `collision ahead` 0, 진행 없음 0, collision monitor 개입 0. 경로 계획 실패 29회는 모두 초반(힌트 14, 첫 탐색 목표 (1.59, −0.01) 14).
  **확인 안 한 것:** 실제 파지·도착 위치(사용자 육안), 초반 계획 실패 원인, SLAM 지도가 벽 틈 너머 x 10 m까지 그려져 경기장 밖이
  탐색 목표가 되는 문제(10회차에 (4.02, 0.34)).
- **11회차 계획 실패 29회 분석 (10-16):** 힌트 14회(처음엔 미탐색이라 경로가 있다가 6 s 뒤 지도 갱신으로 막힘)와 첫 탐색 목표
  (1.59, −0.01) 14회(보내자마자 실패, 직선 0.64 m지만 벽 너머). 각각 Nav2 BT 재시도(대기 5 s × 6)로 23 s씩 씀.
  `frontier_goal`이 직선거리로 가장 가까운 경계를 골라 라이다가 벽 너머로 넘겨 본 바닥도 목표가 됐음
  (11회차 최종 지도는 x −8.9~11.4 m, 옛 함수는 출발점 뒤 벽 밖 (−0.5, 0.07)을 고름).
- **수정 (10-16, 사용자: "경기장에 400 mm 미만 틈은 없다 — 보이는 틈은 길로 보고 닿지만 않게"):**
  ① `frontier_goal`은 로봇에서 벽과 `frontier_passage`(0.075 m) 이상 떨어진 바닥으로 이어진 경계만 고름 → 벽 너머 바닥 제외,
  지도에 0.2 m 이상으로 보이는 틈은 길. 11회차 지도: 도달 영역 x −0.12~3.18·y −0.25~1.55(모의 경기장), 남은 경계 0 → 탐색 완료.
  출발 칸 벽까지 0.200 m(SLAM 벽 정확), 통로 기준 0.075~0.15 사이에서 잘려 나가는 영역 없음.
  ② `frontier_clearance` 0.22 → 0.15: 400 mm 외길 통로 가운데(지도상 벽 0.15~0.20 m)도 목표가 될 수 있게.
  ③ 전역 비용지도 계획용 `robot_radius` 0.150 → 0.075: 5 cm 칸에서 벽이 통로 안쪽에 한 칸씩 찍히면 400 mm 통로가 300 mm로 보여
  반경 0.150이면 막힘. `drive_config.py`는 motor.yaml 반경을 로컬 비용지도에만 넣음(전역은 nav2.yaml 값 유지).
  여유영역은 0.35/6.0을 제안했으나 **사용자 결정으로 0.17/3.0 유지**.
  `run_nav2_check.py` 거부 목표는 바깥벽 너머 (2.3, 0)으로(계획 반경이 작아 상자 벽 위 목표는 허용오차 안에 빈 칸이 생김).
- **사용자 관찰 (11회차): 큐브 접근 중 몸통 옆면에 걸린 장애물을 그대로 밀고 감.** 접근 단계는 카메라 방향만 보고 직진하고,
  collision monitor 원(0.165)은 몸체 바깥선과 같아 여유가 없으며, 측면 PSD 정지는 시험용 펌웨어에서 꺼져 있음.
  11회차 접근 구간 collision monitor 개입 0, `Data is ignored` 경고 0(스캔은 정상 수신), 라이다는 모든 방향 유효.
  → **수정:** 접근 직진(카메라 정렬 직진·놓친 뒤 잠깐 직진·PSD 직진) 때마다 라이다로 몸통 앞쪽 절반 옆
  (`side_guard_reach` 0.165, `side_guard_width` 0.18)에 점이 3개 이상이면 직진을 멈추고 `# ABORT SIDE_LIDAR` 보드 정지처럼 처리
  (정지 횟수 포함, 뒤로 7.5 cm 후 다시 찾음). 큐브(50 mm)는 라이다 아래라 안 걸림, 400 mm 통로 가운데 벽(0.20 m)도 안 걸림,
  Nav2 주행에는 쓰지 않음. `run_mission1_check.py`에 옆 장애물 → 후진 → 재접근 단계 추가(고치기 전 코드는 이 단계에서 실패 확인).
  검증: pytest cwu_nav 20, 흐름 검사 15/15, `run_nav2_check.py` 4/4(도달 0.09 m, 복귀 0.10 m, 벽 너머 거부), flake8, Pi 테스트 12.
- **12회차 (10-16 1시 0x): 사용자 중지.** 95 s 힌트로 가던 중 보드 `# ABORT ENCODER_NO_PULSE`(바퀴 명령은 갔는데 엔코더 펄스 없음 —
  무언가에 막혀 바퀴가 못 돎으로 추정), 그때 PSD 앞 551·좌 565. 후퇴 뒤 다시 힌트로 가던 중 사용자가 멈춤. 걸린 곳은 미확인.
- **13회차 (10-16 1시 1x): 성공, 186 s 보유 복귀(로그 기준).** 30 s 반시계 299° → 힌트 실패(계획 실패 14회, 23 s) →
  113 s "갈 곳이 없습니다"(이어진 경계 없음 → 힌트부터 다시) → 120 s 큐브 발견 → PSD 직진 3번째에 정면 675로 139 s 파지 →
  141~186 s 복귀. 측면 감시 개입 0, collision monitor 개입 2, 보드 정지 1(파지), 진행 없음 0.
  **남은 것:** 막힌 힌트에 BT 재시도로 23 s, PSD 직진이 "보드 정지 없음"으로 두 번 헛돎(11·13회차 모두 3번째에 파지),
  실제 파지·도착 위치는 사용자 육안 확인 필요.
- **13회차 제자리 22 s 분석:** 31~92 s는 힌트 쪽이 미탐색이라 Nav2가 우회로를 따라 움직였고, 92~114 s는 지도가 채워져 경로가
  없어지자 BT가 "실패 → 대기 1·5 s → 재시도"를 반복하며 서 있었음. 힌트 (1.18, 1.18)는 출발 영역과 이어지지 않은 별도 공간
  (모의 경기장이 3.6 m보다 작아 경기장 밖에 떨어짐).
- **수정 (10-16, 사용자 결정):** ① **Nav2 경로 재시도 없음** — `navigate_safe.xml`·`navigate_through_safe.xml`에서 계획 실패 대기·재계획과
  바깥 재시도(대기 5 s)를 뺌. 계획이 실패하면 바로 실패 → 미션이 다른 목표로 (가상 시험: 벽 너머 목표 포기 22 s → 0.0 s).
  따라가기 실패만 로컬 비용지도를 지우고 한 번 더(기다림 없음), 복귀 재시도는 미션이 2 s마다.
  ② **막다른 곳 되돌기 (탐색 중에만)** — 라이다 중앙값으로 앞(±20°)·좌(60~120°)·우(−120~−60°) < 0.35 m이고 뒤(160~200°) > 0.5 m면
  목표를 실패 목록에 넣고 SPIN(트인 쪽으로 돌며 둘러봄) → 다음 목표. 앞 0.35 = 막다른 칸 하나 안(끝 칸 옆 꺾임 오판 방지),
  뒤 트임 조건으로 돌아선 뒤 다시 걸리지 않음. 큐브 접근·복귀에는 안 씀(큐브가 막다른 곳 안에 있을 수 있음).
  `run_mission1_check.py`에 Nav2 목표를 진행 중으로 붙잡은 채 막다른 곳 스캔 → 목표 버리고 다음 목표 단계 추가.
- **14회차 (1시 4x): 측면 감시 오작동으로 미션 중단(166 s).** 큐브 발견 뒤 접근 중 `SIDE_LIDAR` 9회 → "60 s 안에 정지 9회".
  라이다: 몸통 옆 0.17~0.21 m의 나란한 벽(닿지 않음)에 폭 0.18 기준이 걸림(스캔마다 13~17점). → **`side_guard_width` 0.165**
  (몸체 반경: 이보다 안쪽 점만 직진하면 부딪힘). 01:45:45 정상 종료 절차(`stop_mission1.sh`와 같은 순서)로 꺼짐 — 내 명령 아님.
- **15회차 (1시 5x): 측면 감시가 진짜 장애물에 9회 → 미션 중단(150 s).** 오른쪽 PSD 400~440. 라이다 그림: 폭 0.55~0.6 m 통로에
  로봇이 15° 비스듬히 들어가 큐브를 조준 → 오른쪽 벽이 진행선으로 좁혀 옴. 후퇴 7.5 cm로는 각도가 안 바뀌어 같은 직선으로 재접근 반복.
  → **비켜 가기 (사용자 선택):** 막힌 쪽 반대로 5°씩 돌려 감시 영역이 빌 가장 작은 각도(최대 25°, 카메라 화각 안)를 찾아
  제자리 회전 → 2 s 직진(측면 감시 유지) → 다시 조준. 25°로도 안 비거나 한 접근에 6회 넘거나 PSD 직진 중이면 후퇴
  (`detour_max_deg` 25, `detour_s` 2.0, `max_detours` 6). 원형 몸체라 제자리 회전은 새로 닿는 곳 없음. 고정 TF 흐름 검사는
  회전 명령·회전 못 하면 후퇴까지만 확인 — 돈 뒤 직진·재조준은 실물에서만.
- **라이다 시작 실패 (2시 0x, 3회):** `cannot retrieve Lidar health code -2` → `Failed to start the lidar`. USB(CP210x)는 연결,
  본체 무응답. 설정은 정상 판과 같음 → 사용자 조치(케이블·전원) 뒤 `health status good`, 10.3 Hz.
- **16회차 (2시 1x): 99 s 파지(지금까지 가장 빠름), 복귀 계획 157회 실패 → 다익스트라로 바꿔 508 s 보유 복귀(로그 기준).**
  SLAM 지도·비용지도 모두 로봇(2.76, 0.20)→출발점 길 있음, 로봇 칸 비어 있음(벽 0.30 m). 지도 446×56칸(대부분 미탐색)·꼬불꼬불한 길에서
  NavFn A*만 실패 — 실행 중 `GridBased.use_astar false`로 바꾸자 실패 0, 44 s 만에 복귀.
  → **`nav2.yaml` `use_astar: false`**, 가상 시험 4/4, 복귀 구간 계획기 지연 경고 0. 측면 감시·비켜 가기·막다른 곳 0회.
  검증(이번 묶음): pytest cwu_nav 22, 흐름 검사 17/17, `run_nav2_check.py` 4/4, flake8, Pi 테스트 12.
- **16회차 실패 분석 (10-16 오전):** 내가 실행 중 설정을 바꾸지 않았다면 복귀 못 함 — 규정상 미션 중 외부 조작 불가,
  10분 제한 시간 초과 판정(출발점과 큐브 거리)으로 감. 101~461 s 같은 자리(2.76, 0.20)에서 같은 요청이 2 s마다 같은 실패.
  ① **원인 범위:** 같은 지도·같은 자세에서 바꾼 것은 `use_astar` 하나 → A*가 원인. "반복 상한"은 확인 안 된 추정이었음:
  Humble NavFn 소스상 A*는 이웃 갱신 비교에 거리 추정값을 더하고(다익스트라는 실제 비용만) 목표 칸에 처음 닿으면 멈춤.
  PC에서 당시 지도 그림(0.1 m)으로 446×56 지도를 되살려 실제 planner_server로 7종(밖 미탐색·밖 빈 칸·빛줄기 5종) 시험 →
  A*·다익스트라 모두 성공(3.75/3.59 m), 재현 안 됨. 경고(확산이 집에 못 닿음)만 셌고 오류
  `Failed to create a plan from potential`(닿았는데 경로 추출 실패)은 안 셈 → **Pi `~/mission1.log`에 남아 있음, 다음 실행이 덮어쓰기 전에 복사.**
  ② **구조 문제:** RETURN은 실패하면 2 s 뒤 같은 요청을 무한 반복(`retry_wait_s`). 로봇이 서 있으면 지도·자세가 안 바뀌어
  계획기가 무엇이든 결정론적 실패가 끝없이 이어짐(7회차 138회, 13회차 22 s도 같은 꼴). 다익스트라도 비용지도에 길이 없으면 똑같음.
  ③ 보드 `# ABORT` 1회 — 시각·종류 미확인(로그). ④ `hold_min_raw: 0`이라 "보유 복귀"는 센서 확인 아님. ⑤ 실제 도착 위치 미측정.
- **실물 남은 순서:** ① ~~RealSense 장착·전원~~ (웹캠으로 결정) ② 400 mm 모의 칸에서 측면·후면 PSD 값(550 이상이면 출발 칸에서 회전 불가 → 펌웨어 측면 검사 재검토)
  ③ 바퀴 띄우고 `ros2 service call /encoder_odom/carry std_srvs/srv/SetBool "{data: true}"` ④ 큐브 문 상태 정면 PSD → `hold_min_raw`,
  RealSense 검출 거리 ⑤ 개활지 접근·파지·복귀 3회 ⑥ 모의 경기장 전체 3회 (`ros2 topic info /cmd_vel`로 velocity_smoother 0 섞임 확인).

## BASE_NAV_V1 펌웨어 전환 (2026-10-14)

보드 펌웨어를 팀원의 `RobotIntegrated.ino`(BASE_NAV_V1, 규약 `README_STM_PI_INTERFACE.md`)로 바꿨습니다.
**아래 Nav2 시험 결과는 V3 펌웨어 기준**입니다.

- 업로드: 기본 ini(`SERIAL_UART_INSTANCE` 없음, 스케치가 `Uart PiSerial(PC_11,PC_10)` 직접 사용)로 빌드 →
  Pi `st-flash --reset write ~/firmware_integrated_2026-10-14.bin 0x08000000`. V3 백업 Pi `~/board_backup_2026-10-14.bin`.
- `encoder_odom` 새 규약: 시작 때 `[N1]`(정지 중 20 Hz CSV, 없으면 정지 상태에서 텔레메트리 0) →
  `[ARM]` 한 번 → `/cmd_vel`을 `[V mm/s,rad/s]` 20 Hz(150 mm/s·1.2 rad/s 넘으면 비율 유지 축소).
  ABORT·REJECT·STOP을 받으면 무장 해제, 자동 재무장 없음: `ros2 service call /encoder_odom/arm std_srvs/srv/Trigger`.
  REJECT·CSV 0.5 s 끊김이면 `q`. 부팅(`# ROBOT40_V4 READY`)·`z`이면 틱 기준점 재설정. `cmd_timeout` 0.25 s.
  `[G]` 이득과 `!`는 없어짐(바퀴 속도 PI는 펌웨어 안).
- 실물 확인(바퀴 정지 상태): `# ARMED`, `/odom` 20.3 Hz, 서비스 응답.
- **odom 값은 펌웨어 팀 실측값 그대로** (사용자 결정, README 7절): `counts_per_mm_left/right` 5.992624/5.900948,
  `wheel_separation` 0.1904, 부호 +1(전진 증가). 기어비 때문에 손으로 밀 수 없어 부호 실물 확인은 생략.
  이전 스캔 정합값(반지름 0.04158, 좌우 배율, 회전 방향별 간격 0.1975/0.2040)과 `wheel_separation_cw`는 지움(커밋 5abb92c에 있음).
- **확인 안 한 것:** ① 펌웨어 속도 PI는 초기값(README 10절). ② PSD 4개가 raw 550 이상이면 펌웨어가 ABORT
  (제자리 회전은 4방향 모두 검사). 벽 가까이에서 Nav2 회전 중 자주 멈출 수 있음.
- `tools/pwm_step.py`·`tick_measure.py`는 V3 전용(`[G]`, 틱/s `[V]`)이라 새 펌웨어에서는 쓰면 안 됨.

## Nav2 출발점 복귀 시험 (2026-10-12)

**결론:** Nav2로 출발점 복귀는 동작함(3회차 "복귀 완료"). 다만 실제 위치 오차가 아직 합격선(15 cm)을 넘음
(1회차 20 cm/28°, 3회차 19 cm/9.4°). 원인을 찾아 설정을 바꿨으나 **바꾼 설정으로 실물 재시험은 아직 못 함**.

### 구성
- 실행: `slam.launch.py drive:=true cmd_vel_topic:=cmd_vel_safe` + `cwu_nav nav2.launch.py drive:=true`
  (모든 주행 명령이 collision monitor를 거침). 복귀: `ros2 run cwu_nav go_home` (map 원점 = SLAM 시작 자세).
- `motor.yaml` 실측: 최대 0.10 m/s, 0.5 rad/s, 제동 0.04 m(0.1 m/s에서 실측 2.0/1.8 cm, 0.22 s).
- 실제 복귀 오차는 SLAM이 아니라 **출발 스캔 vs 도착 스캔 정합**으로 잼(SLAM 위치를 초기값으로,
  방향 ±40° 탐색). 멀리 간 지점에서 SLAM과 2~3 cm 일치해 측정법 검증됨.

### 시험 결과와 고친 것
| 회차 | 결과 | 원인 | 조치 |
|---|---|---|---|
| 1 | 처음엔 안 움직임 | collision monitor 사각 "stop" 영역(±0.30 m)에 옆/뒤 물체가 들어오면 회전·후진까지 막혀 갇힘 | 원형 몸체 **approach** 방식(반경 0.215 m, 0.7 s 예측)으로 교체 (`drive_config.py`, `nav2.yaml`) |
| 1 | 복귀 완료, 실제 20 cm/28° | 복귀 중 SLAM이 방향 상실 | (3회차에서 원인 특정) |
| 2 | 경로 계획 실패 | SLAM 지도(정적 레이어)의 유령 장애물이 로봇 0.14 m 안 → 출발 칸 lethal | 전역 costmap에서 static layer 제거, 실시간 스캔 장애물 레이어만, 원점 중심 8×8 m |
| 3 | 복귀 완료, 실제 19.2 cm/9.4° (SLAM은 -8/+2 cm로 착각) | **회전 방향마다 odom 회전 배율이 ~3% 다름** + SLAM이 각도까지 odom을 강하게 믿음(angle_variance_penalty 0.1) | 아래 두 가지 |
| 4 | 출발 못 함 | `tools/loop_obstacle.py`가 TF(map→base_link) 대기에서 멈춤 (원인 미확인) | 내일 |

- **회전 방향별 배율** (녹화 4개, 제자리회전 129쌍, 스캔 정합 기준): 반시계 유효 간격 0.1975 m, 시계 0.2040 m.
  → `encoder.yaml` `wheel_separation: 0.1975`, `wheel_separation_cw: 0.2040` (encoder_odom이 회전 방향으로 선택).
- **SLAM 각도 신뢰 기본값 복귀** (`angle_variance_penalty`/`minimum_angle_penalty` 줄 삭제 → 1.0/0.9).
  3회차 녹화 재생 최종 오차: 기존 14.4 cm/-9.7° → 각도 기본값 6.2 cm/-1.5° → +시계 간격 0.204 1.5 cm/-1.9°.
  거리 신뢰(0.03/0.05)와 정합 간격 0.25 m는 유지.

### 장애물 한 바퀴 시험 (사용자 요청, 미완)
- 사용자가 로봇 **뒤쪽(후면) 정중앙**에 장애물을 둠. 로봇 정면 = 집게·앞 PSD 쪽(`w` 전진 방향).
- 라이다로 찾은 위치: 로봇 뒤 약 1.0~1.2 m, 점 묶음 3개(폭 17 cm + 가는 점 2개) → 중심 (-1.15, -0.09) m, 반경 ~0.2 m.
- 계획: 반경 0.55 m 원 위 경유점 8개로 반시계 한 바퀴 + 복귀, 이어서 시계 방향 (`tools/loop_obstacle.py CX CY R ccw|cw`).

## 내일 할 일 (순서대로)

1. **스택 재시작** (출발 위치에서): Pi에서 SLAM(`drive:=true cmd_vel_topic:=cmd_vel_safe`) → 15 s 후 Nav2(`drive:=true`).
   로봇 현재 자세가 map 원점(출발점)이 됨: `tools/field/restart_stack.sh`.
2. **`loop_obstacle.py` TF 대기 멈춤 수정**: 대기에 시간 제한·로그 추가, `save_scan.py`(같은 방식으로 정상 동작)와 차이 확인.
3. **장애물 한 바퀴 시험**: 반시계·시계 각 3회. 장애물 위치는 시작 때 다시 측정(`find_obstacle.py 180` 방식).
   `tools/field/loop_trial.sh N CX CY 0.55 ccw|cw`. 합격: 매 회 15 cm 이내.
4. **자동주행 → go_home 왕복 3회** (새 설정 검증, `tools/field/trial.sh N 40`). 합격: 15 cm 이내.
5. 오차가 남으면: 녹화로 회전 방향별 배율 재측정(`odom_calib.py`가 방향별 회전비 출력),
   `slam_replay.py`로 설정 비교 후 반영. 이 반복을 합격할 때까지.
6. **집게 쪽 정면 기준 정리**: 라이다가 거꾸로 장착(176.4°)돼 라이다 0°는 로봇 뒤쪽. 혼동 주의.
7. 이후: frontier 자율 탐색(`cwu_nav/explore.py`), 대회 경기장(400 mm 통로)에 맞는 collision 반경·inflation 재검토
   (지금 inflation 0.35 m, 로봇 지름 330 mm라 400 mm 통로 통과 여부 확인 필요).
8. 알려진 한계: 라이다(높이 170 mm)·앞 PSD 모두 못 보는 낮은 장애물이 있음(바퀴만 헛돔). 센서 배치 검토 필요.

### 시험 도구
`tools/field/` (README 참고): `restart_stack.sh`, `trial.sh`, `loop_trial.sh`, `find_obstacle.py`, `save_scan.py`,
`home_err.py`, `timeline.py`, `final_pose.py`. 결과는 `~/ros_CWU/log/field`. 오늘 녹화(trial1~3 등)는 세션 임시 폴더에
있어 남지 않을 수 있음 — Pi `~/bags/`(wander1~3, trial2~4)에는 남아 있음.

## 예전 다음 할 일 (2026-09-29~30)

1. ~~소프트 스타트판이 돌고 있는지 확인(수신만): `ENC` 10 Hz.~~ **완료**: 5초간 52줄 모두 `ENC,0,0`, 최대 간격 0.1 s, 깨진 줄 없음.
2. ~~바퀴 띄운 f/l/b/r 2초 → 출발 순간 깨진 줄이 사라졌는지 확인.~~ **완료(소프트 스타트판)**: 네 방향 모두 150 ms 넘는 공백 없음, 역행 틱 없음, 출발·정지 구간 깨진 줄 없음. 틱이 54 → 123 → 147로 올라가 소프트 스타트 동작 확인. t=0.0에 보인 `,19,-28` 같은 조각은 포트 열 때 버퍼를 비우며 잘린 줄로, 모터가 돌기 전이라 잡음이 아님.
3. ~~바닥 한 바퀴(목표 7298틱) → 실제 각도와 비교.~~ **완료(소프트 스타트판)**: 5.38 s에 7336틱에서 스스로 정지. L −7451 / R +7292틱 → 계산 약 364°, 눈으로 본 실제도 제자리로 돌아옴(각도기 측정은 안 함). 시리얼 멈춤 없음. 달리는 중 4.6 s에 0.2 s 공백·잘린 줄 1개(`ENC,-638`) — 0.3 s 안전 정지 미만. 처음 약 20줄은 0틱(포트 열 때 쌓인 줄로 추정, 미확인). 시험 스크립트 `tools/raw_enc_log.py`(Pi에 복사해 `encoder_odom`을 끈 채 `python3 raw_enc_log.py l 8 floor_l 7298`)는 엔코더가 0.3초 끊기면 즉시 정지함.
4. 여전히 멈추면: 모터선 꼬기·신호선과 분리, Nucleo GND ↔ MDD10A GND 굵은 선 직결. 그래도 안 되면 ST-Link를 우회해 F446 하드웨어 UART를 Pi GPIO UART에 직결(TX·RX·GND, 3.3 V).
5. ~~직진 1 m 앞 방향 정밀 재측정으로 바퀴 반지름 보정.~~ **완료(2026-09-30)**: 실제 0.98 m / 엔코더 1.007 m → 반지름 0.04151 m. 주행 중 짧은 끊김은 거리에 영향 없어 무시하기로 함(사용자 판단, 시험 스크립트 끊김 기준 1 s). 반지름이 줄어 회전 계산값도 약 364° → 354°가 되므로, 제자리 360° 회전을 바닥 각도 표시로 다시 재서 `wheel_separation`을 보정해야 함.
   - 별도 문제: 카메라를 연결한 채 모터를 돌리면 Pi 저전압 + USB 과전류가 이어짐. Pi 5 V 변환기 용량(5.1 V 3 A 이상) 확인 필요.
6. codex 모터 초안 검토.
