hjkim602hjk-lgtm/ROS2_CWU/docs/competition_rules.md

---
title: 대회 규정 정리
aliases:
  - 대회 규정
tags:
  - cwu/rules
---

# 2026 창원대학교 전국대학생 자율로봇경진대회 규정 정리

> 기준 문서:
> **2026(제29회) 창원대학교 전국대학생 자율로봇경진대회 규정(안)**
>
> 이 문서는 로봇 소프트웨어 및 시스템 개발을 위해 원 규정의 핵심 내용을 Markdown 형식으로 정리한 문서이다.
> 규정 해석이 필요한 경우 원본 규정을 최우선 기준으로 한다.

---

# 1. 대회 목적 및 기본 원칙

본 대회는 **통신할 수 없고 기반시설이 부재한 환경에서 자율적으로 임무 수행이 가능한 로봇**을 제작하고 성능을 비교하는 것을 목표로 한다.

대회에서 사용하는 로봇은 자율주행이 가능해야 하며, 정해진 임무를 스스로 수행해야 한다.

## 핵심 원칙

* 로봇은 자율주행 방식으로 동작해야 한다.
* 모든 주요 소프트웨어는 반드시 로봇의 **온보드 컴퓨팅 보드**에서 실행되어야 한다.
* 임무 시작 이후 로봇은 외부 전자기기와 통신할 수 없다.
* 경기장은 대회 시작 직전에 공개된다.
* 경기장 공개 이후 참가자는 프로그램, 코드, 설정값 등을 수정할 수 없다.
* 각 임무마다 별도의 프로그램을 사용하는 것은 허용된다.
* 임무마다 로봇 하드웨어를 변경할 수 없다.

---

# 2. 통신 및 소프트웨어 규정

## 2.1 온보드 컴퓨팅

로봇의 소프트웨어는 모두 로봇에 탑재된 온보드 컴퓨팅 보드에서 구동되어야 한다.

다음 기능을 외부 PC나 외부 서버에 의존해서는 안 된다.

* 센서 처리
* 환경 인식
* 위치 추정
* 지도 생성
* 경로 계획
* 자율주행
* 목표물 탐지
* 행동 판단
* 임무 수행 로직

---

## 2.2 외부 통신

각 임무 시작 후에는 통신 모듈을 차단하며 외부 전자기기와 통신할 수 없다.

외부 전자기기의 예:

* PC
* 노트북
* 조종기
* 외부 서버
* 기타 통신 가능한 전자기기

임무 시작 전 심판의 감독하에 제출한 PC를 돌려받아 무선 통신으로 로봇에 **프로그램 실행 명령**을 전달하는 것은 허용된다.

단, 실행 명령을 제외한 모든 소프트웨어 동작은 온보드에서 이루어져야 한다.

---

## 2.3 경기장 공개 이후 수정 금지

경기장은 대회 시작 직전에 공개된다.

경기장 공개 전에 참가팀은 모든 임무 준비를 완료해야 한다.

Wi-Fi를 사용하는 경우 참가팀은 대회에 사용할 PC와 로봇을 주최 측 Wi-Fi Router에 연결한 후 제출해야 한다.

경기장 공개 이후에는 다음과 같은 인위적인 조작을 할 수 없다.

* 프로그램 수정
* 코드 수정
* 설정 파일 수정
* 파라미터 수정
* 버튼 조작
* 맵 수동 입력
* 경기장 구조를 기반으로 한 수동 설정 변경

따라서 로봇은 공개되지 않은 경기장 구조에 스스로 적응할 수 있어야 한다.

---

# 3. 대회 진행 방식

대회는 총 **두 개의 독립적인 임무**로 구성된다.

1. 자율탐색 및 요구조자 구출
2. 배틀럼블

모든 팀이 첫 번째 임무를 진행한 후 두 번째 임무를 진행한다.

두 임무의 성적에 따라 각각 수상할 수 있으며, 동일 팀이 두 임무에서 중복 수상하는 것도 가능하다.

---

# 4. 로봇 공통 규정

## 4.1 로봇 크기

로봇은 확장 가능한 부품을 최대로 확장한 상태에서도 다음 크기 안에 들어가야 한다.

* 최대 지름: **400 mm**
* 최대 높이: **300 mm**

기준 형태:

* 지름 400 mm
* 높이 300 mm

의 원기둥 내부에 완전히 들어갈 수 있어야 한다.

---

## 4.2 로봇 무게

로봇의 최대 무게는 다음과 같다.

**10 kg 이하**

배터리를 포함한 전체 로봇 기준으로 판단할 수 있다.

---

## 4.3 동력원

로봇의 동력원은 반드시 로봇 내부에 탑재되어 있어야 한다.

금지 사항:

* 외부 전원 공급
* 외부 전원 케이블 연결
* 외부 조종기 사용

외부 동력 공급 또는 외부 조종기를 사용할 경우 실격 처리될 수 있다.

---

## 4.4 하드웨어 변경

대회 중 임무에 따라 로봇의 하드웨어를 변경할 수 없다.

금지 사항:

* 부품 추가
* 부품 제거
* 부품 교환
* 구조 변경
* 미션별 부품 탈착

처음 제출된 로봇 하드웨어로 모든 임무를 수행해야 한다.

단, 경기 진행이 어려울 정도의 경미한 파손이 발생한 경우 심사위원회의 판단에 따라 동일한 부품으로 교체가 허용될 수 있다.

---

## 4.5 배터리 및 수리

다음은 각 미션 시작 전에 가능하다.

* 로봇 수리
* 배터리 교체

미션 수행 중에는 불가능하다.

---

## 4.6 부품 분리 금지

로봇의 모든 부품은 항상 연결되어 있어야 한다.

의도적으로 로봇의 일부를 다음과 같이 사용할 수 없다.

* 분리
* 탈락
* 투척
* 방치

의도적으로 일부 부품을 탈락시키거나 분리하면 실격될 수 있다.

---

## 4.7 위험한 외형

로봇 외부에는 날카롭거나 뾰족한 형태의 위험한 장치를 장착해서는 안 된다.

---

# 5. 경기장 규격

## 5.1 전체 크기

경기장 크기:

**3600 mm × 3600 mm**

형태:

* 정사각형
* 외곽 벽 존재

외곽 벽 높이:

**200 mm**

---

## 5.2 격자 구조

경기장은 총 **9 × 9 격자**로 구성된다.

전체 경기장 크기가 3600 mm × 3600 mm이므로 각 격자는 다음 크기이다.

**400 mm × 400 mm**

---

# 6. 경기장 색상

경기장 내부 기본 색상은 회색조이다.

참고 RGB:

`RGB = (127, 127, 127)`

단, 다음 조건에 따라 실제 센서 입력값은 달라질 수 있다.

* 경기장 조명
* 카메라 특성
* 센서 특성
* 노출
* 화이트밸런스

따라서 RGB 수치는 절대값이 아닌 참고값으로 사용해야 한다.

---

# 7. 장애물 규격

장애물 크기:

* Width: 400 mm
* Depth: 400 mm
* Height: 200 mm

즉,

**400 mm × 400 mm × 200 mm**

직육면체이다.

장애물 사이 공간은 400 mm의 배수로 구성된다.

최소 간격은 400 mm이다.

장애물은 경기장 내부와 동일한 회색 계열의 색상 및 패턴으로 구성된다.

---

## 7.1 장애물 고정

장애물은 움직이지 않도록 고정된다.

로봇이 장애물을 다음과 같이 처리할 경우 실격될 수 있다.

* 이동
* 파손
* 밀어냄
* 경기 진행이 어려운 정도의 훼손

---

# 8. 경기 시작 절차

심판의 시작 신호 이후 참가자는 지정된 위치에서 로봇을 구동한다.

이후 참가자는 원격 PC를 logout하고 경기장으로부터 **20 cm 이상 떨어진 안전 구역 밖**으로 이동해야 한다.

경기 종료 이전에 참가자가 경기장 주변 20 cm 이내로 접근하면 실격될 수 있다.

---

# 9. Mission 1 — 자율탐색 및 요구조자 구출

## 9.1 경기 방식

첫 번째 임무는 두 팀이 한 조를 이루어 진행한다.

조별 우승팀을 선정한 후 우승팀끼리 다시 경기를 진행하는 토너먼트 방식이다.

---

## 9.2 경기 시간

제한 시간:

**10분**

---

## 9.3 시작 위치

두 로봇은 각각 다음 위치에서 시작한다.

* `(1, 9)`
* `(9, 1)`

로봇은 지정된 위치에서 구동한 후 외부 통신을 차단해야 한다.

---

# 10. Mission 1 경기장 구조

Mission 1에는 장애물이 존재한다.

장애물 배치는 `(5,5)` 격자를 기준으로 **점대칭** 형태로 구성된다.

구체적인 장애물 배치는 로봇 및 PC가 수거된 후 공개된다.

따라서 미리 정해진 장애물 지도를 기반으로 로봇을 개발할 수 없다.

---

# 11. Mission 1 목표

로봇은 경기 영역을 자율적으로 탐색해야 한다.

최종 목표:

1. 경기장 탐색
2. 관심 대상 발견
3. 관심 대상 접근
4. 관심 대상 확보
5. 관심 대상을 자신의 시작 위치로 운송

관심 대상을 먼저 시작 지점으로 운송한 팀이 승리한다.

---

# 12. 관심 대상 / 요구조자 규격

Mission 1의 관심 대상은 정육면체이다.

크기:

**50 mm × 50 mm × 50 mm**

무게:

**약 100 g**

색상:

**무광 빨간색**

참고 RGB:

`RGB = (255, 0, 0)`

초기 위치:

`(5,5)`

관심 대상은 지면 위에 놓여 있으며 고정되어 있지 않다.

실제 센서에서 측정되는 RGB 값은 조명 및 센서 특성에 따라 달라질 수 있다.

---

# 13. 관심 대상 이동 및 탈취

Mission 1에서는 관심 대상의 위치를 이동시키는 것에 제한이 없다.

상대 로봇이 관심 대상을 확보한 상태에서도 탈취할 수 있다.

따라서 목표물 확보 장치는 다음 상황을 고려할 필요가 있다.

* 이동 중 목표물 유지
* 상대 로봇과의 접촉
* 목표물 탈취
* 목표물 재확보

---

# 14. Mission 1 승리 조건

## 정상 승리

관심 대상을 자신의 시작 위치까지 먼저 운송한 팀이 승리한다.

---

## 시간 초과

두 팀 모두 제한 시간 내에 관심 대상을 시작 위치로 운송하지 못한 경우:

**시작 지점과 관심 대상까지의 상대 거리가 더 가까운 팀이 승리한다.**

상대 거리는 심판이 판단한다.

---

## 동일 거리

두 팀 모두 제한 시간 내 운송하지 못하고 관심 대상의 상대 위치가 동일한 경우:

**양 팀 모두 탈락한다.**

---

# 15. Mission 2 — 배틀럼블

Mission 2는 네 팀이 동시에 경쟁한다.

각 조별 우승팀을 선정한 후 우승팀끼리 다시 경쟁하는 토너먼트 방식이다.

각 조 구성은 대회 당일 결정된다.

---

# 16. Mission 2 경기 시간

제한 시간:

**5분**

---

# 17. Mission 2 경기장

Mission 2에서는 경기장 내부 장애물을 제거한다.

네 로봇은 다음 격자에서 시작한다.

* `(2,2)`
* `(2,8)`
* `(8,2)`
* `(8,8)`

경기 시작 후 외부 통신을 차단한다.

---

# 18. Mission 2 목표

각 로봇은 경기장 중심에 배치된 빨간색 요구조자를 탐색하고 확보해야 한다.

요구조자의 색상:

`RGB = (255, 0, 0)`

RGB 값은 참고값이다.

---

# 19. Mission 2 요구조자 확보 판정

요구조자 확보 여부는 다음 기준으로 판단한다.

로봇을 지면에 수직하게 들어 올렸을 때:

**요구조자가 로봇과 함께 들리면 확보한 것으로 인정한다.**

따라서 단순히 요구조자에 접촉하거나 밀고 있는 상태만으로는 확보한 것으로 인정되지 않을 수 있다.

---

# 20. Mission 2 탈취

다른 로봇이 확보하고 있는 요구조자를 탈취하는 것이 허용된다.

따라서 요구조자 확보 구조는 다음 상황을 고려해야 한다.

* 충돌
* 밀림
* 당김
* 탈취
* 다중 로봇 동시 접촉

---

# 21. Mission 2 로봇 간 물리적 접촉

Mission 2에서는 상대 로봇을 미는 것이 허용된다.

단, 상대 로봇을 고의적으로 파손하는 것은 허용되지 않는다.

---

# 22. Mission 2 탈락 영역

경기장의 각 모서리 격자는 탈락 영역으로 사용된다.

로봇이 모서리 격자까지 밀리거나 이동하면 즉시 탈락할 수 있다.

로봇의 절반 이상이 모서리 격자에 들어간 경우 심판의 판단에 따라 탈락 여부가 결정된다.

따라서 로봇은 자신의 위치와 경기장 모서리 영역을 인식할 필요가 있다.

---

# 23. 요구조자를 가진 로봇이 탈락한 경우

탈락한 로봇이 요구조자를 확보하고 있었다면 요구조자는 즉시 경기장 중앙의 원래 위치로 재배치된다.

만약 원래 위치에 다른 로봇이 존재하는 경우 심판이 요구조자를 주변에 배치한다.

이후 경기는 계속 진행된다.

---

# 24. Mission 2 승리 조건

경기 제한 시간이 끝났을 때 요구조자를 확보하고 있는 로봇의 팀이 승리한다.

---

# 25. 다수 로봇 동시 확보

경기 종료 시 2개 이상의 로봇이 동시에 요구조자를 확보한 경우가 존재할 수 있다.

판정 예:

여러 로봇이 요구조자를 중심으로 강하게 결합되어 있으며, 해당 로봇들을 동시에 수직으로 들어 올렸을 때 요구조자가 같이 들리는 경우.

이 경우 해당 팀들을 대상으로 **3분 재경기**를 진행한다.

---

# 26. 재경기에서도 동시 확보한 경우

재경기 종료 시에도 여러 팀이 요구조자를 동시에 확보하고 있으면:

**더 먼저 요구조자를 확보한 팀이 우승한다.**

단, 확보 후 요구조자를 놓쳤다가 다시 확보한 경우에는 다시 확보한 시점을 기준으로 계산한다.

즉,

**경기 종료 시점부터 역산했을 때 요구조자를 연속적으로 가장 오래 확보하고 있던 팀이 우승한다.**

---

# 27. Mission 2 순위 결정

조별 우승팀 이외의 같은 조 내 순위는 로봇 전체 무게로 평가한다.

평가 기준:

**더 가벼운 로봇이 높은 순위**

배터리를 포함한 전체 로봇 무게를 기준으로 한다.

---

# 28. 실격 가능 조건

다음과 같은 경우 심사위원회가 로봇을 실격시킬 수 있다.

## 로봇 관련

* 로봇 규격 위반
* 외부 전원 사용
* 외부 조종기 사용
* 허가되지 않은 하드웨어 변경
* 허가되지 않은 소프트웨어 변경

---

## 통신 관련

경기 중 허가된 프로그램 실행 순간을 제외하고 외부 전자기기와 통신한 경우.

---

## 참가자 개입

경기 종료 전에 참가자가 경기장 주변 20 cm 이내로 접근한 경우.

---

## 코드 및 파라미터 수정

대회 중 참가자가 직접 다음 항목을 수정한 경우.

* 소스 코드
* 코드 파일
* 설정 파일
* 매개변수 파일
* 기타 소프트웨어 구성

---

## 경기장 훼손

로봇이 경기장 또는 관심 대상을 경기 진행이 불가능할 정도로 파괴하거나 손상시킨 경우.

---

## 조기 출발

심판의 시작 선언 전에 로봇이 움직인 경우.

---

## 비신사적 행동

참가팀이 비신사적인 행동을 한 경우.

---

# 29. 무기 및 공격 장치 제한

의도적인 무기 사용은 제한된다.

다음 유형의 장치는 실격 사유가 될 수 있다.

---

## 발사형 장치

로봇이 발사한 뒤 스스로 회수하고 재장착할 수 없는 장치.

---

## 액체 및 화염

다음과 같은 장치는 금지된다.

* 액체를 사용하는 공격 장치
* 불
* 화염

---

## 경기장 파손 장치

경기장을 훼손할 가능성이 있는 장치.

---

## 전기 및 전자 공격

상대 로봇의 회로를 의도적으로 손상시키기 위한 다음 장치.

* 전기충격
* 전자파 발생 장치

---

## 센서 방해

상대 로봇의 센서 동작을 방해할 수 있는 구성품 또는 장치.

---

## 날카로운 무기

날카롭거나 뾰족한 형태의 무기.

---

# 30. 심사위원회의 권한

심사위원회는 다음과 같은 경우 로봇을 실격시킬 수 있다.

* 로봇을 대여하여 참가한 경우
* 참가자가 자신의 로봇 하드웨어 구성을 설명하지 못하는 경우
* 참가자가 자신의 로봇 소프트웨어 구성을 설명하지 못하는 경우
* 경기 시작 후 허가되지 않은 통신이 발생한 경우
* 대회 중 사람이 하드웨어 또는 소프트웨어를 수정한 경우
* 심사위원이 대회 규정에 반한다고 판단한 경우

참가팀은 자신의 로봇 구조와 소프트웨어 동작 원리를 설명할 수 있어야 한다.

---

# 31. 개발 시 반드시 고려해야 할 요구사항

본 대회 규정에 따라 로봇 소프트웨어는 다음 조건을 만족해야 한다.

## 완전 자율 동작

임무 시작 이후 다음 기능을 사람의 개입 없이 수행해야 한다.

* 센서 데이터 수집
* 주변 환경 인식
* 장애물 탐지
* 지도 생성 또는 환경 표현
* 위치 추정
* 목표물 인식
* 목표물 위치 추정
* 경로 생성
* 장애물 회피
* 목표물 접근
* 목표물 확보
* 목표물 운송
* 임무 상태 판단

---

## 미지 환경 대응

경기장 구조는 사전에 알 수 없기 때문에 특정 장애물 배치를 하드코딩해서는 안 된다.

로봇은 센서를 이용해 경기 환경을 실시간으로 파악해야 한다.

---

## 외부 연산 금지

임무 수행 중 외부 컴퓨터에 다음 작업을 맡기는 구조를 사용해서는 안 된다.

* SLAM
* Navigation
* Camera Processing
* AI Inference
* Object Detection
* Mission Planning
* Remote Control

필요한 연산은 온보드 컴퓨터에서 처리해야 한다.

---

# 32. Mission 1 소프트웨어 요구사항

Mission 1에서는 최소한 다음 기능이 필요하다.

1. 자율 탐색
2. 장애물 감지
3. 장애물 회피
4. 자기 위치 추정
5. 목표물 탐지
6. 목표물 위치 추정
7. 목표물 접근
8. 목표물 확보
9. 시작 지점 위치 기억
10. 시작 지점으로 복귀
11. 목표물을 유지한 상태에서 이동

---

# 33. Mission 2 소프트웨어 요구사항

Mission 2에서는 최소한 다음 기능을 고려할 수 있다.

1. 경기장 중앙 방향 탐색
2. 요구조자 탐지
3. 요구조자 접근
4. 요구조자 확보
5. 요구조자 유지
6. 다른 로봇과의 충돌 대응
7. 경기장 경계 인식
8. 모서리 탈락 영역 회피
9. 요구조자 탈취 또는 재확보
10. 요구조자 확보 상태 판단

---

# 34. Mission 공통 기능

두 Mission에서 공통으로 활용할 수 있는 기능은 다음과 같다.

* LiDAR 센서 처리
* Depth Camera 처리
* 로봇 위치 추정
* 장애물 및 객체 인식
* 로봇 기본 주행 제어
* 요구조자 탐지
* 요구조자 접근
* 요구조자 확보
* 안전 제어
* ROS 2 통신
* 하드웨어 인터페이스

---

# 35. Mission별 분리 가능 기능

규정상 각 임무마다 독립적인 프로그램 작성이 허용된다.

따라서 소프트웨어는 공통 기능과 Mission 전용 로직을 분리하는 구조가 적합하다.

예:

* `mission1`

  * exploration
  * rescue
  * return_to_start

* `mission2`

  * target_capture
  * target_retention
  * corner_avoidance
  * opponent_interaction

---

# 36. 중요 규정 요약

개발 과정에서 특히 다음 규정을 항상 확인한다.

### Rule 1

모든 주요 소프트웨어는 온보드에서 실행한다.

### Rule 2

임무 시작 이후 외부 통신을 사용하지 않는다.

### Rule 3

경기장 공개 이후 코드나 파라미터를 수정하지 않는다.

### Rule 4

경기장 구조를 미리 알고 있다는 가정으로 코드를 작성하지 않는다.

### Rule 5

Mission별 소프트웨어는 분리할 수 있지만 하드웨어는 변경할 수 없다.

### Rule 6

로봇의 최대 무게는 10 kg이다.

### Rule 7

최대 확장 상태에서도 지름 400 mm, 높이 300 mm 원기둥 안에 들어가야 한다.

### Rule 8

상대 로봇 또는 경기장을 파손하는 전략을 사용하지 않는다.

### Rule 9

상대 로봇의 센서나 전자장치를 방해하는 장치를 사용하지 않는다.

### Rule 10

Mission 2에서는 상대를 미는 것은 허용되지만 고의적인 파손은 허용되지 않는다.

---

# 37. 개발 원칙

프로젝트의 모든 코드와 시스템 설계는 본 문서의 규정을 우선적으로 만족해야 한다.

새로운 기능을 추가할 때는 다음을 확인한다.

* 온보드에서 실행 가능한가?
* 외부 통신에 의존하는가?
* 경기장 공개 후 사람이 수정해야 하는가?
* 특정 경기장 구조에 하드코딩되어 있는가?
* Mission 1과 Mission 2 모두에서 사용할 하드웨어인가?
* 로봇 규격을 위반하지 않는가?
* 다른 로봇 또는 경기장에 위험을 줄 가능성이 있는가?
* 센서 방해 또는 전자적 공격 요소가 존재하는가?

위 조건 중 하나라도 문제가 있다면 해당 설계는 수정해야 한다.

---

# 38. 규정 외 사항

규정에 명시되지 않은 사항은 심사위원회의 판단에 따른다.

경기장 또는 대회 상황에 따라 심사위원회가 규정을 수정 적용할 수 있다.

참가 팀 수에 따라 경기 방식이 변경될 수도 있다.

따라서 실제 대회 참가 시에는 반드시 주최 측에서 배포한 **최종 확정 규정**을 다시 확인해야 한다.

## 관련 문서

- [[docs/프로젝트 목차|프로젝트 목차]] — 전체 문서와 파일 탐색
- [[AGENTS|규정을 적용한 개발 원칙]]
- [[docs/superpowers/plans/2026-09-10-competition-plan|규정에서 도출한 구현 계획]]
