hjkim602hjk-lgtm/ROS2_CWU/docs/superpowers/plans/2026-09-08-slam.md

---
title: 2D SLAM 구현 및 검증 기록
aliases:
  - SLAM 구현 기록
tags:
  - cwu/implementation-record
---

# 2D SLAM Implementation Plan

**Goal:** Deliver an encoder-assisted ROS 2 SLAM bringup and hardware-free demo.
**Architecture:** G4 /scan + encoder odom TF feed SLAM Toolbox. A separate synthetic
sensor executable replaces both inputs for development only.
**Tech Stack:** ROS 2 Humble, Python, SLAM Toolbox, Nav2 map saver.
**Spec:** `docs/superpowers/specs/2026-09-08-slam-design.md`

## Constraints
Onboard mission computation; no prebuilt arena map; YAML tuning; no fabricated
encoder protocol or geometry; no motor commands; no hardware required for tests.
The workspace has no usable Git metadata, so edits remain here without commits.
Execution is inline in this session using executing-plans.

## Resume verification — 2026-09-09

Recovered the interrupted session and verified the existing implementation:
- Full workspace build: all 3 packages passed, including the G4 driver and SDK.
- `colcon test` / `colcon test-result`: 12 tests, 0 errors, 0 failures.
- `run_demo_check.py`: 72×72 map, 3792 free and 152 occupied cells;
  moving odometry, scan, TF and saved PGM/YAML passed.
  Artifacts: `/tmp/cwu-slam-check-_cdg_f2l/`.
- Real launch `--show-args` passed without hardware.
- Korean README and reproducible SDK library-path patch are present.

Build and colcon test stalled inside the sandbox; both completed successfully
outside it. No source changes were needed during resumption. Hardware validation
and encoder-driver implementation remain outside this completed software scope.
The original checklist below preserves the implementation plan, not live status.

## Tasks
- [ ] Write numerical tests in `src/cwu_slam/test/test_geometry.py`: axis and
  diagonal wall distances, nearest occluder, parallel/missing ray intersections,
  sensor rotation and translation, and invalid range clipping to infinity.
  Run pytest and confirm missing geometry implementation fails.
- [ ] Implement `cwu_slam/geometry.py`: `raycast(x, y, angle, walls, range_min,
  range_max)` returns the nearest segment intersection or positive infinity.
  Run the same tests and require all pass.
- [ ] Implement `demo_sensors.py`, package metadata, config/*.yaml and launch/*.
  Demo publishes scan and odometry with matching stamps and TF. Real and demo
  launch files remain separate. Configure SLAM, mount TF and optional RViz.
- [ ] Add `test/slam_smoke.py` to subscribe to map/odom/scan, check changing odom,
  free/occupied cells and map-to-base TF, then save a map with map_saver_cli.
- [ ] Build with colcon, run numerical tests through colcon test, launch demo and
  run smoke verification. Inspect real launch arguments without a serial device.
- [ ] Write Korean README with dependency commands, encoder contract, demo/real
  launch commands, mapping save commands, pre-mission calibration and limitations.

## 관련 문서

- [[docs/프로젝트 목차|프로젝트 목차]] — 전체 문서와 파일 탐색
- [[docs/superpowers/specs/2026-09-08-slam-design|구현의 설계 근거]]
- [[README|실행 및 재검증 방법]]
- [[docs/superpowers/plans/2026-09-10-competition-plan|이후 대회 기능 개발 계획]]
