hjkim602hjk-lgtm/ROS2_CWU/docs/superpowers/plans/2026-10-30-mission2.md

# 미션2 구현 계획

> **For agentic workers:** REQUIRED SUB-SKILL: superpowers:executing-plans. Steps use `- [ ]`.

**Goal:** 미션2(빠른 확보 → (3,3)~(7,7) 순환, 보유 상대 모서리 밀기)를 미션1과 분리된 노드로 구현하고 Gazebo 배틀 시뮬레이션으로 검증.
**Architecture:** ROS 없는 판단 함수 `cwu_nav/mission2_logic.py`(pytest) + 상태머신 노드 `cwu_nav/mission2.py`. SLAM 없이
odom + 벽 맞춤으로 경기장 좌표. 시뮬레이션은 `cwu_sim`에 새 world 생성기·심판/상대 노드·launch를 추가하고 기존 `fake_board`·`robot()`을 재사용.
**Spec:** `docs/superpowers/specs/2026-10-30-mission2-design.md`

## Global Constraints

- 미션1 파일(`mission1.py`, `grid.py`, `mission1.yaml`, `maze.py`, `fake_board.py`)은 수정하지 않음 — 다른 세션이 작업 중. import만.
- 경기장 좌표: 원점 중앙, 칸 (i,j) 중심 ((i-5)·0.4, (j-5)·0.4). 출발 = (2,2) 중심, 진행 방향 +x(중앙이 왼쪽).
- 모서리 칸 = |x|>1.4 그리고 |y|>1.4. 고리 = 꼭짓점 (±0.8, ±0.8) 정사각형, 반시계.
- 튜닝값은 전부 `src/cwu_nav/config/mission2.yaml`.
- 보드 인터페이스: `/cmd_vel`, `/base/command`("ARM","7","8","PF0","PF1"), `/base/telemetry`(PSD 6~9, 서보 10~11), `/base/event`.

## Review Focus

- 쥔 채 밀려 엔코더가 미끄러짐 → 벽 맞춤이 위치를 되찾아야 함 (`test_wall_fix_recovers_shift`).
- 벽 근처 상대 로봇 점이 벽 맞춤을 끌어당김 → 중앙값으로 버팀 (`test_wall_fix_ignores_robot_near_wall`).
- 어떤 상태에서든 모서리 칸으로 들어가는 속도 → 0 (`test_corner_guard_*`).
- 정면에 상대가 붙은 채 PSD 근접 → 닫지 않음 (`test_robot_ahead`).
- 상대 보유 판정이 바닥 큐브 앞을 지나는 로봇에 속음 → 시뮬레이션에서 확인.

---

### Task 1: 판단 함수 `mission2_logic.py`

**Files:** Create `src/cwu_nav/cwu_nav/mission2_logic.py`, Test `src/cwu_nav/test/test_mission2_logic.py`

**Produces:**
- `START = (-1.2, -1.2, 0.0)`
- `in_corner(x, y, margin=0.0) -> bool`
- `corner_guard(pose, v, w, margin, lookahead) -> (v, w)` — 예측 위치가 모서리 영역(여유 포함)으로 더 들어가면 v=0
- `ring_target(pose, half=0.8, lead=0.3) -> (x, y)` — 반시계 정사각형 위 lead 앞 점
- `pursue(pose, target, v_max, k, turn_only_rad) -> (v, w)`
- `wall_fix(points_arena, tol, min_points) -> (dx, dy) | None` — 벽 x,y=±1.8 근처 점의 중앙값 잔차
- `robots(points_arena, wall_margin, gap, min_points, max_extent) -> [(x, y)]`
- `robot_on_bearing(own_xy, bearing, robots, tol) -> (x, y) | None` — 방향선에 가장 가까운 로봇
- `push_plan(own_pose, opp, behind, lateral_tol) -> (target_xy, pushing: bool)`
- `flee_target(own_pose, opp, step, margin) -> (x, y)`
- `robot_ahead(points_base, half_width, reach) -> bool`

- [ ] 테스트 작성(위 Review Focus 포함) → 실패 확인 → 구현 → `python3 -m pytest src/cwu_nav/test/test_mission2_logic.py -q` 통과

### Task 2: 상태머신 `mission2.py` + 설정 + launch + 현장 스크립트

**Files:** Create `src/cwu_nav/cwu_nav/mission2.py`, `src/cwu_nav/config/mission2.yaml`, `src/cwu_nav/launch/mission2.launch.py`,
`tools/field/m2_start.sh`, `tools/field/m2_stop.sh`, `tools/field/m2_logs.sh`; Modify `src/cwu_nav/setup.py`(entry `mission2`)

상태: `INIT → RELEASE → SPIN → (APPROACH | PUSH | RUSH) → GRASP → HOLD`, 어디서든 300 s → `FINISH`.
launch: LiDAR + encoder_odom + laser 고정 TF + 카메라 + mission2 (SLAM 없음).

- [ ] `colcon build --packages-select cwu_nav` 성공, `ros2 run cwu_nav mission2 --ros-args -p ...` 가 텔레메트리 없이 대기 로그를 냄

### Task 3: 배틀 시뮬레이션

**Files:** Create `src/cwu_sim/cwu_sim/battle.py`(world), `src/cwu_sim/cwu_sim/referee.py`(상대 3대 + 심판),
`src/cwu_sim/launch/battle.launch.py`, `tools/sim/run_battle.sh`; Modify `src/cwu_sim/setup.py`

- 큐브 이름 `victim`(fake_board가 `target`만 지우므로 지워지지 않음). 우리 보유 = 텔레메트리 서보 [99,78] + 정면 600.
- 상대: diff_drive 원통(밀 수 있음), 속도 시드별. 바닥 큐브로 → 쥐면 안쪽 배회 → 안 쥔 상대는 보유자 추격.
- 심판: 보유자 앞에 큐브 붙임, 모서리 진입 탈락(상대는 경기장 밖으로), 보유자 탈락 시 큐브 중앙 재배치, 300 s 판정 한 줄.

- [ ] `tools/sim/run_battle.sh 1` 이 결과 한 줄을 냄 → 여러 시드 반복하며 수정
