hjkim602hjk-lgtm/ROS2_CWU/tools/field/motion_results/README.md

# 주행 시험 기록 (2026-10-31)

`tools/field/motion_test.sh`로 만든 결과입니다. 시험마다 `motion_speed_<시각>.csv`(20 Hz 텔레메트리 + 목표 속도)와
`motion_turn_<시각>.csv`(회전·직진의 엔코더 대 라이다 실제 방향)가 짝이고, 같은 이름의 `.png`가 그림입니다.
그림·요약 다시 만들기: `python3 tools/field/plot_motion_test.py motion_speed_<시각>.csv motion_turn_<시각>.csv`

| 시각 | 시험 | 조건 | 결과 요약 |
|---|---|---|---|
| 100617 | 속도·회전 | 첫 시도 | 보드 무장 실패(펌웨어 빌드 설정 잘못), 기록 없음 |
| 100828 | 속도 계단 0.08~0.25 + 회전 90/180 | 펌웨어 PWM 255·속도 상한 해제, 보정 전 | 가속 느려 2 s 안에 목표 못 닿음(끝 속도 65~135 mm/s), 회전 ±2° |
| 101557 | 1 m 왕복 0.25 | 보정 전 (cpm_R 5.671) | 최고 246 mm/s, 직진 실제 -5.6°/-4.6° (오른쪽으로 휨) |
| 101840 | 1 m 왕복 0.25 | cpm_R 5.773 | 직진 -0.0°/+0.6° |
| 102052, 102201 | 1 m 왕복 0.25 반복 | cpm_R 5.773 | 직진 -1.0~+1.4° |
| 102348 | 1 m 왕복 0.25 | cpm_R 5.73 | 직진 -2.6°/-2.3° |
| 102558 | 1 m 왕복 0.25 | cpm_R 5.765, 윤거 0.1996 | 직진 -0.1°/+0.6°, 180° 회전 -0.1° |
| 102927 | 1 m 왕복 | 출발 보조 34/22 (첫 펄스까지) | 시험 중 로봇 옮김 — 라이다 값 무효 |
| 103052 | 1 m 왕복 | 출발 보조 34/22 (5 mm까지) | 출발 방향 -0.8° (왼쪽 먼저) |
| 103227 | 1 m 왕복 | 출발 보조 31/24 | 출발 방향 +2.2° (오른쪽 먼저) |
| 103435 | 1 m 왕복 | 출발 동기화(1 mm) | 회전 중 PSD로 중단 (벽 세우는 중) |
| 103631 | 1 m 왕복 0.25 | 출발 동기화, 벽 세움 | 출발 방향 +0.3~0.5°, 엔코더 옆 밀림 -0.7/-0.2 cm |
| 103946 | 1 m 왕복 0.4 | 출발 동기화 | 최고 352 mm/s, PWM 249/248 (255 닿음) |
| 104138 | 회전 90/180 × 2 | 회전 보정 전 | 90° 평균 0.8° 모자람 (마지막 회전 PSD로 중단) |
| 104509 | 회전 | +1° 보정 | PSD 한 표본 튐으로 중단 |
| 104604 | 회전 90/180 × 2 | +1° 보정 (turn_extra_deg) | 8번 모두 ±1.5° 안 |
| 12:06~12:12 (4쌍) | 1 m 왕복 0.25 × 4 | 펌웨어 가속 제한 100/200/300/400 mm/s² | 90% 도달 3.35/2.60/2.3/2.20 s, 1 m 6.6/6.0/5.7/5.6 s, 출발 방향 ≤1.6°, PWM 최대 ~181 (PI 이득이 낮아 300 넘으면 거의 안 빨라짐) |

라이다 "실제 방향"은 벽이 2 m 안에 보일 때만 믿을 수 있음 (103631 이전 일부는 벽 없음). 1 m 지점의 측정은 보이는 벽이
달라 ±4° 치우치는 일이 있었음 — 직진 휨은 같은 자리에서 잰 회전 시험·왕복 합계와 함께 볼 것.
미션 주행 텔레메트리(10-29~10-31, Pi `~/telemetry_*.csv` 사본)는 `mission_telemetry/`.
