hjkim602hjk-lgtm/ROS2_CWU/tools/field/motion_results/mission_telemetry/telemetry_20261029_232219.csv

pi_time | stm_ms | mode | enc_l | enc_r | pwm_l | pwm_r | psd_front | psd_rear | psd_left | psd_right | servo_l | servo_r
1793283745.773 | 859443 | 0 | 0 | 0 | 0 | 0 | 41 | 481 | 90 | 302 | 40 | 140
1793283745.813 | 859493 | 0 | 0 | 0 | 0 | 0 | 6 | 481 | 100 | 364 | 40 | 140
1793283745.873 | 859543 | 0 | 0 | 0 | 0 | 0 | 17 | 480 | 82 | 292 | 40 | 140
1793283745.913 | 859593 | 0 | 0 | 0 | 0 | 0 | 7 | 479 | 130 | 292 | 40 | 140
1793283745.972 | 859643 | 0 | 0 | 0 | 0 | 0 | 13 | 480 | 132 | 309 | 40 | 140
1793283746.013 | 859693 | 0 | 0 | 0 | 0 | 0 | 7 | 481 | 159 | 347 | 40 | 140
1793283746.073 | 859743 | 0 | 0 | 0 | 0 | 0 | 6 | 477 | 99 | 291 | 40 | 140
1793283746.112 | 859793 | 0 | 0 | 0 | 0 | 0 | 21 | 481 | 108 | 293 | 40 | 140
1793283746.172 | 859843 | 0 | 0 | 0 | 0 | 0 | 144 | 480 | 120 | 347 | 40 | 140
1793283746.212 | 859893 | 0 | 0 | 0 | 0 | 0 | 1 | 544 | 148 | 305 | 40 | 140
1793283746.253 | 859943 | 0 | 0 | 0 | 0 | 0 | 4 | 481 | 106 | 354 | 40 | 140
1793283746.313 | 859993 | 0 | 0 | 0 | 0 | 0 | 57 | 478 | 21 | 298 | 40 | 140
1793283746.352 | 860043 | 0 | 0 | 0 | 0 | 0 | 12 | 480 | 114 | 285 | 40 | 140
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
