hjkim602hjk-lgtm/ROS2_CWU/tools/field/motion_results/mission_telemetry/telemetry_20261029_235403.csv

pi_time | stm_ms | mode | enc_l | enc_r | pwm_l | pwm_r | psd_front | psd_rear | psd_left | psd_right | servo_l | servo_r
1793285649.446 | 2796826 | 0 | 56156 | 59751 | 0 | 0 | 7 | 210 | 40 | 322 | 40 | 140
1793285649.482 | 2796876 | 0 | 56156 | 59751 | 0 | 0 | 6 | 211 | 49 | 290 | 40 | 140
1793285649.539 | 2796926 | 0 | 56156 | 59751 | 0 | 0 | 10 | 208 | 31 | 272 | 40 | 140
1793285649.578 | 2796976 | 0 | 56156 | 59751 | 0 | 0 | 114 | 314 | 111 | 392 | 40 | 140
1793285649.638 | 2797026 | 0 | 56156 | 59751 | 0 | 0 | 6 | 208 | 46 | 297 | 40 | 140
1793285649.682 | 2797076 | 0 | 56156 | 59751 | 0 | 0 | 8 | 214 | 41 | 290 | 40 | 140
1793285649.740 | 2797126 | 0 | 56156 | 59751 | 0 | 0 | 7 | 209 | 10 | 339 | 40 | 140
1793285649.779 | 2797176 | 0 | 56156 | 59751 | 0 | 0 | 6 | 206 | 5 | 284 | 40 | 140
1793285649.848 | 2797226 | 0 | 56156 | 59751 | 0 | 0 | 6 | 209 | 93 | 263 | 40 | 140
1793285649.881 | 2797276 | 0 | 56156 | 59751 | 0 | 0 | 8 | 209 | 7 | 298 | 40 | 140
1793285649.938 | 2797326 | 0 | 56156 | 59751 | 0 | 0 | 5 | 209 | 41 | 310 | 40 | 140
1793285649.978 | 2797376 | 0 | 56156 | 59751 | 0 | 0 | 4 | 211 | 223 | 294 | 40 | 140
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
