hjkim602hjk-lgtm/ROS2_CWU/tools/field/motion_results/mission_telemetry/telemetry_20261029_235725.csv

pi_time | stm_ms | mode | enc_l | enc_r | pwm_l | pwm_r | psd_front | psd_rear | psd_left | psd_right | servo_l | servo_r
1793285852.205 | 3003076 | 0 | 62017 | 72067 | 0 | 0 | 15 | 86 | 286 | 345 | 40 | 140
1793285852.250 | 3003126 | 0 | 62017 | 72067 | 0 | 0 | 17 | 85 | 279 | 349 | 40 | 140
1793285852.302 | 3003176 | 0 | 62017 | 72067 | 0 | 0 | 33 | 87 | 285 | 418 | 40 | 140
1793285852.361 | 3003226 | 0 | 62017 | 72067 | 0 | 0 | 17 | 77 | 403 | 475 | 40 | 140
1793285852.401 | 3003276 | 0 | 62017 | 72067 | 0 | 0 | 150 | 216 | 294 | 347 | 40 | 140
1793285852.461 | 3003326 | 0 | 62017 | 72067 | 0 | 0 | 26 | 78 | 398 | 468 | 40 | 140
1793285852.505 | 3003376 | 0 | 62017 | 72067 | 0 | 0 | 37 | 72 | 280 | 346 | 40 | 140
1793285852.546 | 3003426 | 0 | 62017 | 72067 | 0 | 0 | 108 | 90 | 282 | 345 | 40 | 140
1793285852.601 | 3003476 | 0 | 62017 | 72067 | 0 | 0 | 6 | 88 | 282 | 344 | 40 | 140
1793285852.641 | 3003526 | 0 | 62017 | 72067 | 0 | 0 | 25 | 188 | 390 | 391 | 40 | 140
1793285852.708 | 3003576 | 0 | 62017 | 72067 | 0 | 0 | 63 | 83 | 280 | 341 | 40 | 140
1793285852.745 | 3003626 | 0 | 62017 | 72067 | 0 | 0 | 23 | 90 | 282 | 432 | 40 | 140
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
