hjkim602hjk-lgtm/ROS2_CWU/tools/field/motion_results/mission_telemetry/telemetry_20261030_000642.csv

pi_time | stm_ms | mode | enc_l | enc_r | pwm_l | pwm_r | psd_front | psd_rear | psd_left | psd_right | servo_l | servo_r
1793286409.052 | 3569176 | 0 | 66633 | 76596 | 0 | 0 | 7 | 495 | 452 | 331 | 40 | 140
1793286409.071 | 3569226 | 0 | 66633 | 76596 | 0 | 0 | 16 | 498 | 453 | 331 | 40 | 140
1793286409.132 | 3569276 | 0 | 66633 | 76596 | 0 | 0 | 48 | 626 | 584 | 335 | 40 | 140
1793286409.172 | 3569326 | 0 | 66633 | 76596 | 0 | 0 | 7 | 498 | 456 | 336 | 40 | 140
1793286409.232 | 3569376 | 0 | 66633 | 76596 | 0 | 0 | 11 | 497 | 452 | 331 | 40 | 140
1793286409.271 | 3569426 | 0 | 66633 | 76596 | 0 | 0 | 122 | 500 | 453 | 344 | 40 | 140
1793286409.331 | 3569476 | 0 | 66633 | 76596 | 0 | 0 | 6 | 499 | 456 | 335 | 40 | 140
1793286409.385 | 3569526 | 0 | 66633 | 76596 | 0 | 0 | 22 | 497 | 451 | 341 | 40 | 140
1793286409.762 | 3569576 | 0 | 66633 | 76596 | 0 | 0 | 78 | 620 | 574 | 340 | 40 | 140
1793286409.778 | 3569926 | 0 | 66633 | 76596 | 0 | 0 | 165 | 609 | 453 | 333 | 40 | 140
1793286409.818 | 3569976 | 0 | 66633 | 76596 | 0 | 0 | 140 | 500 | 450 | 334 | 40 | 140
1793286409.871 | 3570026 | 0 | 66633 | 76596 | 0 | 0 | 145 | 635 | 454 | 335 | 40 | 140
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
