hjkim602hjk-lgtm/ROS2_CWU/tools/field/motion_results/mission_telemetry/telemetry_20261030_011600.csv

pi_time | stm_ms | mode | enc_l | enc_r | pwm_l | pwm_r | psd_front | psd_rear | psd_left | psd_right | servo_l | servo_r
1793290567.709 | 413572 | 0 | 0 | 0 | 0 | 0 | 9 | 193 | 339 | 327 | 40 | 140
1793290567.760 | 413622 | 0 | 0 | 0 | 0 | 0 | 82 | 322 | 470 | 341 | 40 | 140
1793290567.820 | 413672 | 0 | 0 | 0 | 0 | 0 | 6 | 197 | 342 | 317 | 40 | 140
1793290567.862 | 413722 | 0 | 0 | 0 | 0 | 0 | 8 | 193 | 465 | 449 | 40 | 140
1793290567.921 | 413772 | 0 | 0 | 0 | 0 | 0 | 35 | 195 | 345 | 325 | 40 | 140
1793290567.960 | 413822 | 0 | 0 | 0 | 0 | 0 | 9 | 198 | 342 | 316 | 40 | 140
1793290568.000 | 413872 | 0 | 0 | 0 | 0 | 0 | 10 | 196 | 347 | 324 | 40 | 140
1793290568.060 | 413922 | 0 | 0 | 0 | 0 | 0 | 6 | 196 | 340 | 328 | 40 | 140
1793290568.100 | 413972 | 0 | 0 | 0 | 0 | 0 | 93 | 321 | 471 | 322 | 40 | 140
1793290568.160 | 414022 | 0 | 0 | 0 | 0 | 0 | 12 | 193 | 341 | 329 | 40 | 140
1793290568.200 | 414072 | 0 | 0 | 0 | 0 | 0 | 134 | 320 | 342 | 321 | 40 | 140
1793290568.263 | 414122 | 0 | 0 | 0 | 0 | 0 | 8 | 193 | 344 | 322 | 40 | 140
1793290568.300 | 414172 | 0 | 0 | 0 | 0 | 0 | 136 | 395 | 480 | 525 | 40 | 140
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
