hjkim602hjk-lgtm/ROS2_CWU/tools/field/motion_results/mission_telemetry/telemetry_20261030_011915.csv

pi_time | stm_ms | mode | enc_l | enc_r | pwm_l | pwm_r | psd_front | psd_rear | psd_left | psd_right | servo_l | servo_r
1793290762.018 | 611024 | 0 | 28250 | 31147 | 0 | 0 | 13 | 89 | 153 | 321 | 40 | 140
1793290762.058 | 611074 | 0 | 28250 | 31147 | 0 | 0 | 23 | 94 | 210 | 305 | 40 | 140
1793290762.118 | 611124 | 0 | 28250 | 31147 | 0 | 0 | 64 | 206 | 280 | 304 | 40 | 140
1793290762.173 | 611174 | 0 | 28250 | 31147 | 0 | 0 | 30 | 81 | 155 | 316 | 40 | 140
1793290762.217 | 611224 | 0 | 28250 | 31147 | 0 | 0 | 13 | 80 | 155 | 307 | 40 | 140
1793290762.260 | 611274 | 0 | 28250 | 31147 | 0 | 0 | 25 | 77 | 158 | 308 | 40 | 140
1793290762.317 | 611324 | 0 | 28250 | 31147 | 0 | 0 | 15 | 70 | 155 | 311 | 40 | 140
1793290762.360 | 611374 | 0 | 28250 | 31147 | 0 | 0 | 258 | 268 | 209 | 308 | 40 | 140
1793290762.417 | 611424 | 0 | 28250 | 31147 | 0 | 0 | 149 | 205 | 169 | 425 | 40 | 140
1793290762.459 | 611474 | 0 | 28250 | 31147 | 0 | 0 | 60 | 205 | 281 | 308 | 40 | 140
1793290762.498 | 611524 | 0 | 28250 | 31147 | 0 | 0 | 21 | 176 | 283 | 383 | 40 | 140
1793290762.560 | 611574 | 0 | 28250 | 31147 | 0 | 0 | 23 | 63 | 281 | 434 | 40 | 140
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
