hjkim602hjk-lgtm/ROS2_CWU/tools/field/motion_results/motion_speed_20261031_102927.png

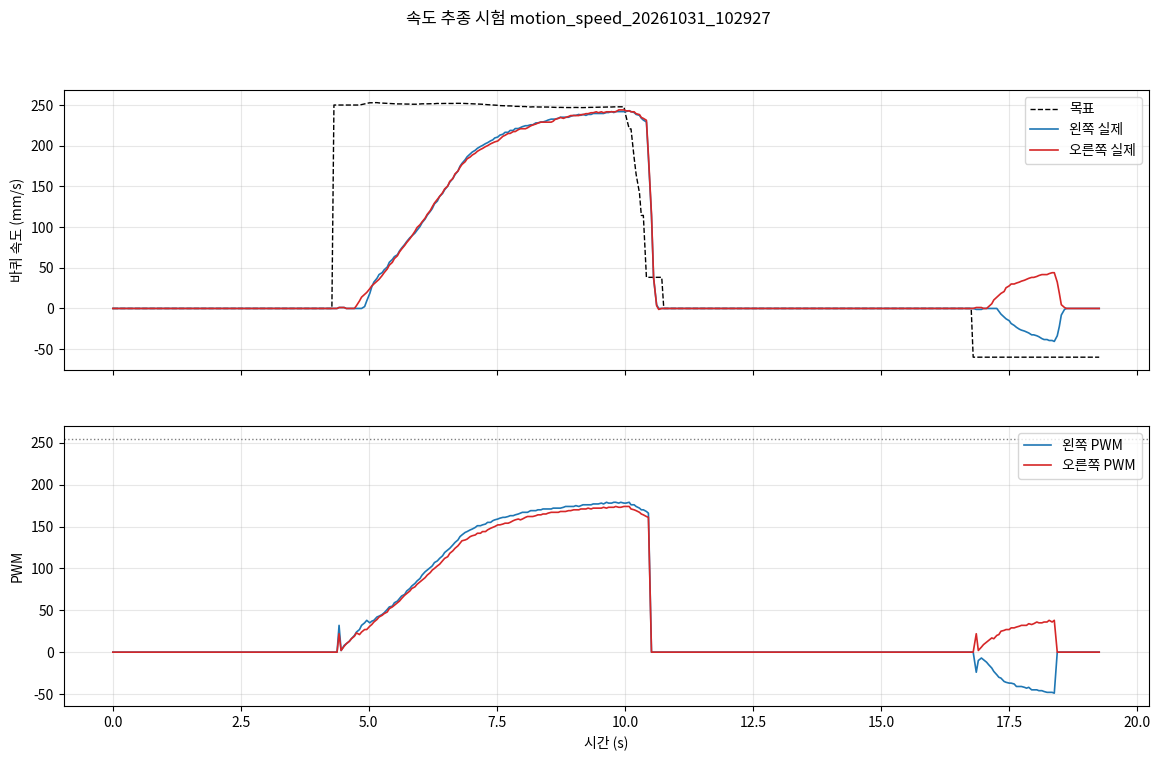
tools/field/motion_results/motion_speed_20261031_102927.png
