hjkim602hjk-lgtm/ROS2_CWU/tools/field/motion_results/motion_turn_20261031_100828.png

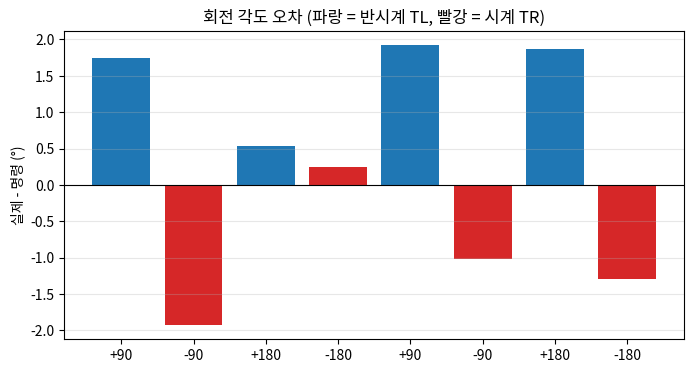
tools/field/motion_results/motion_turn_20261031_100828.png
