hjkim602hjk-lgtm/ROS2_CWU/tools/field/motion_results/run13_start_motor.png

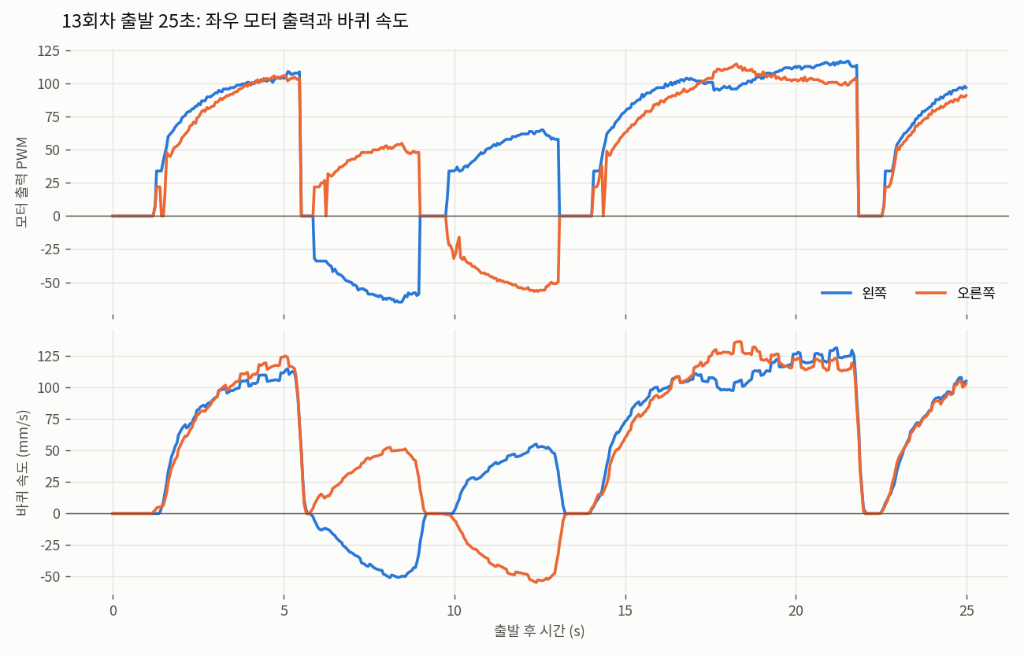
tools/field/motion_results/run13_start_motor.png
