hjkim602hjk-lgtm/ROS2_CWU/(commit log)

2026-09-09 chore: ROS2 CWU 워크스페이스 초기 커밋
    빌드 산출물과 vcstool로 받아오는 외부 드라이버 소스는 제외.
    Claude-Session: https://claude.ai/code/session_014aYcJmNZV7WZzc76UYK82Z
2026-09-18 feat: 자율주행 스택 연결과 카메라 역할 변경 (방향 인식 + 정렬 서보)
    엔코더 오도메트리(cwu_base), Nav2 주행 설정(cwu_nav), 목표물 인식(cwu_perception)을
    추가하고, 카메라 역할 변경을 반영했습니다.
    카메라 역할 변경 (사용자 확정):
    - 깊이를 측정하지 않습니다. 컬러 영상으로 목표물의 방향만 판단합니다.
    - /target/pose(3D 위치) → /target/bearing(PointStamped, 컬러 광학 프레임 단위 벡터).
    거리를 모르는 채 위치 메시지를 내보내면 소비자가 없는 거리를 좌표로 오해합니다.
    - cwu_nav/target_follower: 방향 오차를 /cmd_vel_servo로. 정렬된 뒤에만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
    [servo.yaml]
2026-09-29 노션 링크 추가 최신화
2026-09-30 feat: Nucleo↔Pi UART 전환과 실물 주행 시험 기록, PSD 4개 배치 반영
    - ST-Link USB 시리얼이 모터 잡음으로 반복해서 멈춰 UART4(A0/A1) ↔ Pi GPIO UART 직결로 전환
    - platformio.ini 빌드 플래그로 Serial = UART4 (코드 수정 없음)
    - ROS 기본 포트 /dev/ttyACM0 → /dev/ttyAMA0
    - 업로드·배선·실물 통신 확인은 아직 안 함
    - 실물 시험 기록(2026-09-29~30)과 보정값: 바퀴 반지름 0.04151 m, 소프트 스타트·명령 만료 펌웨어
    - encoder_odom: 속도 상한을 넘는 깨진 틱 증분 버림 + 회귀 테스트
    - PSD 4개(정면 그리퍼 1 = 파지 트리거 전용, 좌·우·뒤 각 1) 문서 반영
    - codex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
    [motor.yaml]
2026-10-01 김형준이 좋아하는 UART README
2026-10-02 10/1 최신본(UART통신 관련 수정완료 X)
    [bringup.py, demo_sensors.py]
2026-10-08 stm코드 kp.0.30
2026-10-08 일단 최신화
2026-10-11 40cm 주행
2026-10-11 RobotServoCalibrate: 서보 설정 내장, 집게 각도 조정
    - 커밋에서 빠진 ServoSettings.h 대신 서보 상수를 파일에 직접 넣음
    - 시작 L70/R130, 잡기 L130/R70 (실물에서 조정한 값)
    - [L###]/[R###] 허용 범위 0~180 (기계적 한계 측정 전)
    - 보드에 업로드·검증 완료 (2026-10-11)
2026-10-11 RobotServboCalibrate: 그래퍼 위치 조정까지 완료
2026-10-11 V3 펌웨어로 SLAM 키보드 매핑: 주행 명령·라이다 보정
    펌웨어 (RobotServoCalibrate (1).ino, 보드 업로드·검증 완료)
    - [Dl,r] 부호 PWM 주행(MODE_DRIVE), ! 하트비트 필수, 전방 PSD는 전진만 차단
    - w/e 단일 바퀴 연속 회전(틱 측정용, 하트비트 + 10 s 제한)
    - PSD 안전정지 20 ms 디바운스: 모터 출발 잡음으로 즉시 ABORT 되던 문제
    - 텔레메트리 200 -> 50 ms
    ROS
    - encoder_odom: drive:=true 일 때 /cmd_vel -> [D] + 하트비트, '#' 상태줄 무시
    - encoder.yaml: V3 CSV 필드 2/3, 부호 -1, ticks_per_rev 1504.75 (왼쪽 재측정 일치)
    - ydlidar inverted: true (스캔 좌우 반전 실측), mount yaw -165°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
2026-10-11 바퀴 속도 폐루프 + 녹화 기반 odom·SLAM 자동 보정
    자동주행(장애물 회피)으로 녹화한 데이터를 스캔 정합과 비교해 보정.
    로봇 SLAM 국소 오차 5.0 cm / 4.5° -> 1.2 cm / 1.1° (25 cm 구간 기준),
    0.8 m 직진에서 odom/SLAM 0.828/0.818 m (이전 1.036/0.453).
    펌웨어 (보드 업로드·검증 완료)
    - [V좌,우] 바퀴 틱/s 목표, 바퀴별 PI(50 ms), 이득은 [Gff,static,kp,ki] (RAM)
    - 바닥 실측: 300/577/800 틱/s 목표에 좌우 차 4% 이하
    ROS 설정 (실측)
    - encoder_odom: /cmd_vel -> [V], 이득 1 s마다 재전송, 바퀴별 배율, 폴링 5 -> 20 ms (CPU 43%)
    - encoder.yaml: wheel_separation 0.1974, radius 0.04158, left/ri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
2026-10-11 Nav2 출발점 복귀: 충돌 감시·costmap 수정, 회전 방향별 odom 보정
    복귀 시험 3회에서 찾은 문제를 고침. 바꾼 설정의 실물 재시험은 다음에(기록 문서 "내일 할 일").
    - collision monitor: 사각 stop 영역 -> 원형 몸체 approach (옆/뒤 물체에 갇히던 문제)
    - 전역 costmap: SLAM 정적 레이어 제거, 실시간 스캔 장애물 레이어만 (유령 장애물로 경로 계획 실패)
    - encoder_odom: 회전 방향별 바퀴 간격 (반시계 0.1975 / 시계 0.2040, 녹화 4개 129쌍)
    - slam.yaml: 각도 신뢰 기본값으로 (3회차 재생 최종오차 14.4 cm/-9.7° -> 6.2 cm/-1.5°)
    - motor.yaml 실측 한계(0.10 m/s, 0.5 rad/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
2026-10-14 kp0.9용 리드미
2026-10-14 ddㅇㅇ
2026-10-15 미션 1 실행 경로: 탐색·접근·PSD 파지·복귀, BASE_NAV_V1 연동, 실물 조정
    - encoder_odom: BASE_NAV_V1 규약([N1]→[ARM]→[V mm/s,rad/s]), 재무장은 ~/arm 서비스로만,
    /base/telemetry·/base/event, ~/carry(8[PF0]/7[PF1]), 펌웨어 보정값(counts/mm, 윤거 0.1904)
    - mission1 노드·mission_logic·mission1.launch·start/stop 스크립트: 집게 다 연 뒤 시작, 트인 방향만 회전,
    중앙 힌트→탐색 경계, 근거리 정면 PSD 직진, 최근 1 s 정면 PSD로 파지 판정, 출발점 복귀
    - 펌웨어 RobotIntegrated.ino: [PF0]/[PF1] 운반 모드, 제자리 회전은 PSD 정지 없음, PSD 정지 60 ms 유지,
    잡기 99/78, 시험용 SIDE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
2026-10-15 미션 1 모의 경기장 성공: 전역 비용지도를 SLAM 지도로, RPP 충돌 검사 끔
    - nav2.yaml: 전역 비용지도 = static_layer(/map, footprint_clearing_enabled) + inflation.
    스캔 장애물 레이어의 유령 칸이 실제로 뚫린 통로를 막아 로봇이 0.75 m² 안에 갇히던 문제(9회차).
    - nav2.yaml: RPP use_collision_detection false. 5 cm 칸 외곽 검사로 400 mm 통로에서 매번
    collision ahead(10회차). 충돌 방지는 collision monitor + 정면 PSD.
    - slam.rviz: 전역·로컬 비용지도·경로 표시. tools/field/rviz.sh: RViz + 웹캠 디코더.
    - run_nav2_check.py: 거부 시험 목표를 이미 본 상자 벽으로 (안 본 면은 미탐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
2026-10-15 미션 1: 보이는 틈은 길로, 벽 너머 탐색 목표 제외, 접근 중 측면 라이다 감시
    - frontier_goal: 로봇에서 벽과 frontier_passage(0.075) 이상 떨어진 바닥으로 이어진 경계만.
    라이다가 벽 너머로 넘겨 본 바닥이 목표가 되어 Nav2가 23 s씩 재시도하던 문제(11회차).
    frontier_clearance 0.22 → 0.15 (400 mm 외길 통로 안쪽도 목표 가능).
    - 전역 비용지도 계획용 robot_radius 0.075 (경기장 틈은 모두 400 mm 이상, 지도에서 좁게 보여도 길).
    drive_config는 실측 반경을 로컬 비용지도에만. 여유영역은 0.17 유지(사용자 결정).
    - 접근 직진 중 몸통 앞쪽 절반 옆(0.16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
2026-10-15 미션 1: Nav2 재시도 제거·다익스트라, 막다른 곳 되돌기, 접근 중 비켜 가기
    - navigate_safe/through_safe: 경로 계획 실패 대기·재시도 제거 (사용자 결정). 계획 실패면 바로
    실패 → 미션이 다른 목표로. 13회차 막힌 힌트 앞 22 s 제자리 → 0 s.
    - nav2.yaml use_astar false: A*가 길이 있는데도 복귀 계획 157회 실패(16회차, 446x56칸 지도).
    실행 중 다익스트라로 바꾸자 즉시 경로, 44 s 만에 복귀.
    - 탐색 중 막다른 곳(앞·좌·우 < 0.35 m, 뒤 > 0.5 m)이면 목표를 버리고 돌아서 다른 목표.
    - 접근 중 측면 감시 폭 0.18 → 0.165 (나란한 벽에 9번 오작동, 14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
2026-10-30 2026.10.31새벽
2026-11-01 26.11.2 대회 2일전
